abcminiuser/explorerbot/Thesis/Chapters/Chapter7.tex

\chapter{Project Discussion}
\label{chp:discussion}
\lhead{Chapter 7. \emph{Project Discussion}}

% TODO

\section{Issues Faced}

% TODO

\subsection{Motor Inrush Current}

% TODO

\subsection{PCA9306 Physical Package}

% TODO

\subsection{L298D Unavailabilty}

% TODO

\subsection{Incorrect Transistor Pinout}

% TODO

\subsection{Slow Drive Transistors}

% TODO

\subsection{Unreliable Packet Buffering}

% TODO

\subsection{PS3 Controller Compatibility}

% TODO

\subsection{Wii Controller Compatibility}

% TODO

\section{Project Significance}

% TODO
