abcminiuser/explorerbot/Thesis/Chapters/Chapter6.tex

\chapter{Project Results}
\label{chp:results}
\lhead{Chapter 6. \emph{Project Results}}

% TODO

\begin{figure}[tbph]
	\vspace{1em}
	\centering
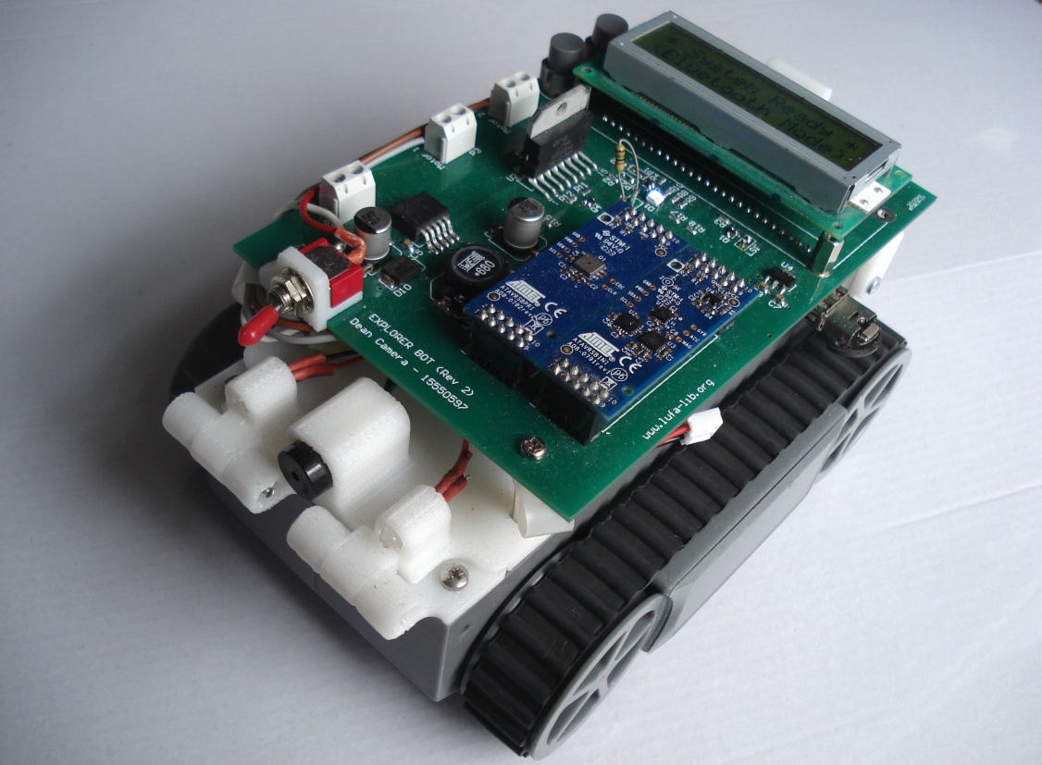
[picture p27: Thesis/Figures/CompletedRobot.jpg]
		
	\rule{35em}{0.5pt}
	\caption[Photo of Completed Robot]{Photo of the completed \textit{ExplorerBot} prototype robot}
	\label{fig:completedrobot}
\end{figure}

\begin{figure}[tbph]
	\vspace{1em}
	\centering
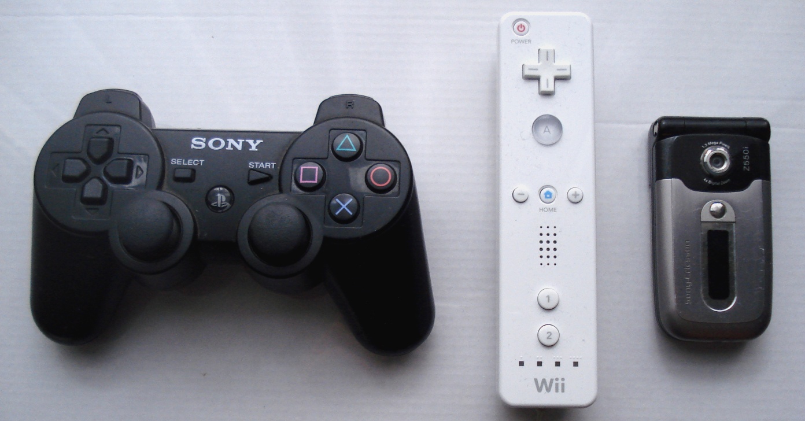
[picture p28: Thesis/Figures/BluetoothControllers.jpg]
		
	\rule{35em}{0.5pt}
	\caption[Tested Working Controllers]{Tested consumer grade Bluetooth enabled devices: \\ Playstation 3 controller \textit{(left)}, Nintendo Wii controller \textit{(middle)}, Sony-Ericcson z550i mobile phone \textit{(right)} }
	\label{fig:workingbtcontrollers}
\end{figure}

\begin{figure}[tbph]
	\vspace{1em}
	\centering
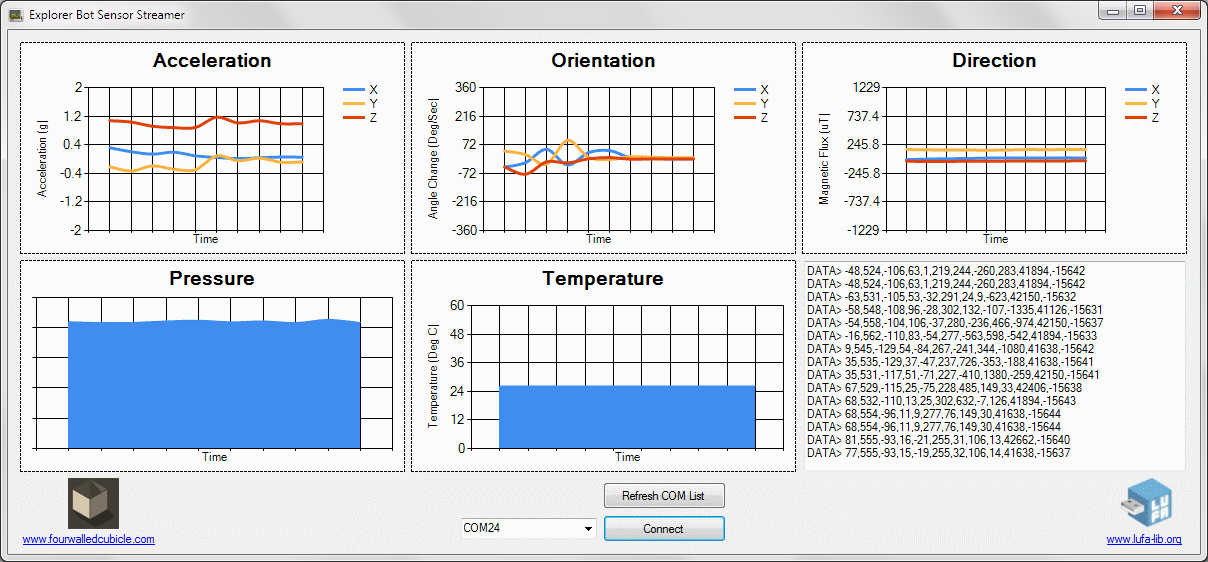
[picture p29: Thesis/Figures/SensorDataApp.png]
		
	\rule{35em}{0.5pt}
	\caption[Sensor Logging Host Application]{Sensor logging application, showing data streaming wirelessly from the connected robot via a Bluetooth virtual serial port. }
	\label{fig:sensorhostapp}
\end{figure}
