abcminiuser/explorerbot/End Year Presentation.pptx

Embedded Bluetooth Stack

Dean Camera
Supervisor: Prof. John Devlin
Co-Supervisor: Robert Ross

## Project Aims

Embedded Bluetooth Stack Page 2

- Develop a functional Bluetooth stack
  - Designed for embedded use
  - Focus on low resource usage
    - Memory Requirements
    - CPU Requirements
  - No RTOS requirements
- Design and build a functional hardware prototype to demonstrate the stack

## Bluetooth Stack

Embedded Bluetooth Stack Page 3

## Bluetooth Stack Layers

Embedded Bluetooth Stack Page 4

SDP

Other Services

High level abstracted services

Logical Link Control
and Adaption Protocol

Logical channel management within a device connection

Baseband management including physical connections between devices

Sends/Receives packets to and from the Bluetooth Controller
  - USB
  - Serial

Host Controller Interface

Physical Transport

## Completed Bluetooth Stack

Embedded Bluetooth Stack Page 5

- Supports multiple concurrent connections
- Multiple logical channels per connection
- L2CAP reliability through a dedicated internal queue
- API for integration into user applications

## Bluetooth Services

Embedded Bluetooth Stack Page 6

- RF Communication (RFCOMM)
  - Server role only
  - Provides wireless serial port functionality
- Human Interface Device (HID)
  - Very basic server implementation
  - Compatible with specific devices only

## Completed Services (Cont)

Embedded Bluetooth Stack Page 7

- Service Discovery Protocol (SDP)
  - Server implementation only
  - Allows for dynamic registration of other services

## Demonstration Hardware

Embedded Bluetooth Stack Page 8

## Hardware Overview

- Small battery operated “ExplorerBot” robot
- Allow for user control over Bluetooth connections
- Onboard sensors with wireless streaming

Embedded Bluetooth Stack Page 9

## Hardware Overview (Cont)

Embedded Bluetooth Stack Page 10

- Atmel Inertial One and Pressure One sensor boards
  - Accelerometer
  - Gyroscope
  - Magnetometer
  - Temperature Sensor
  - Pressure Sensor
- Level Converted I²C Bus

## Completed Prototype

Embedded Bluetooth Stack Page 11

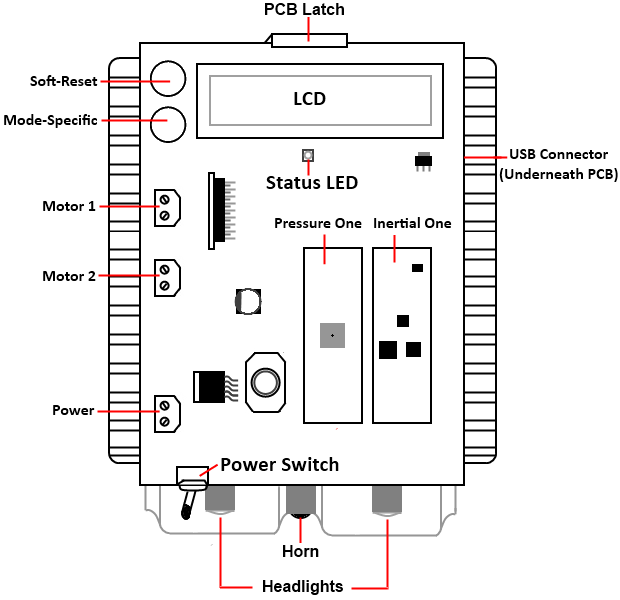
[picture p30: figure]
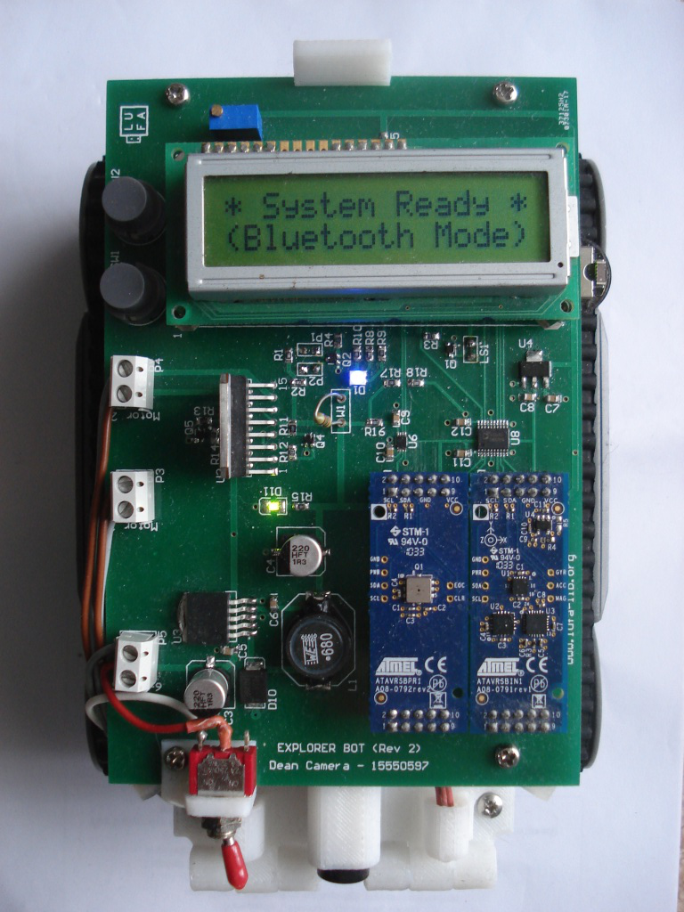
[picture p31: figure]

## Firmware Block Diagram

Embedded Bluetooth Stack Page 12

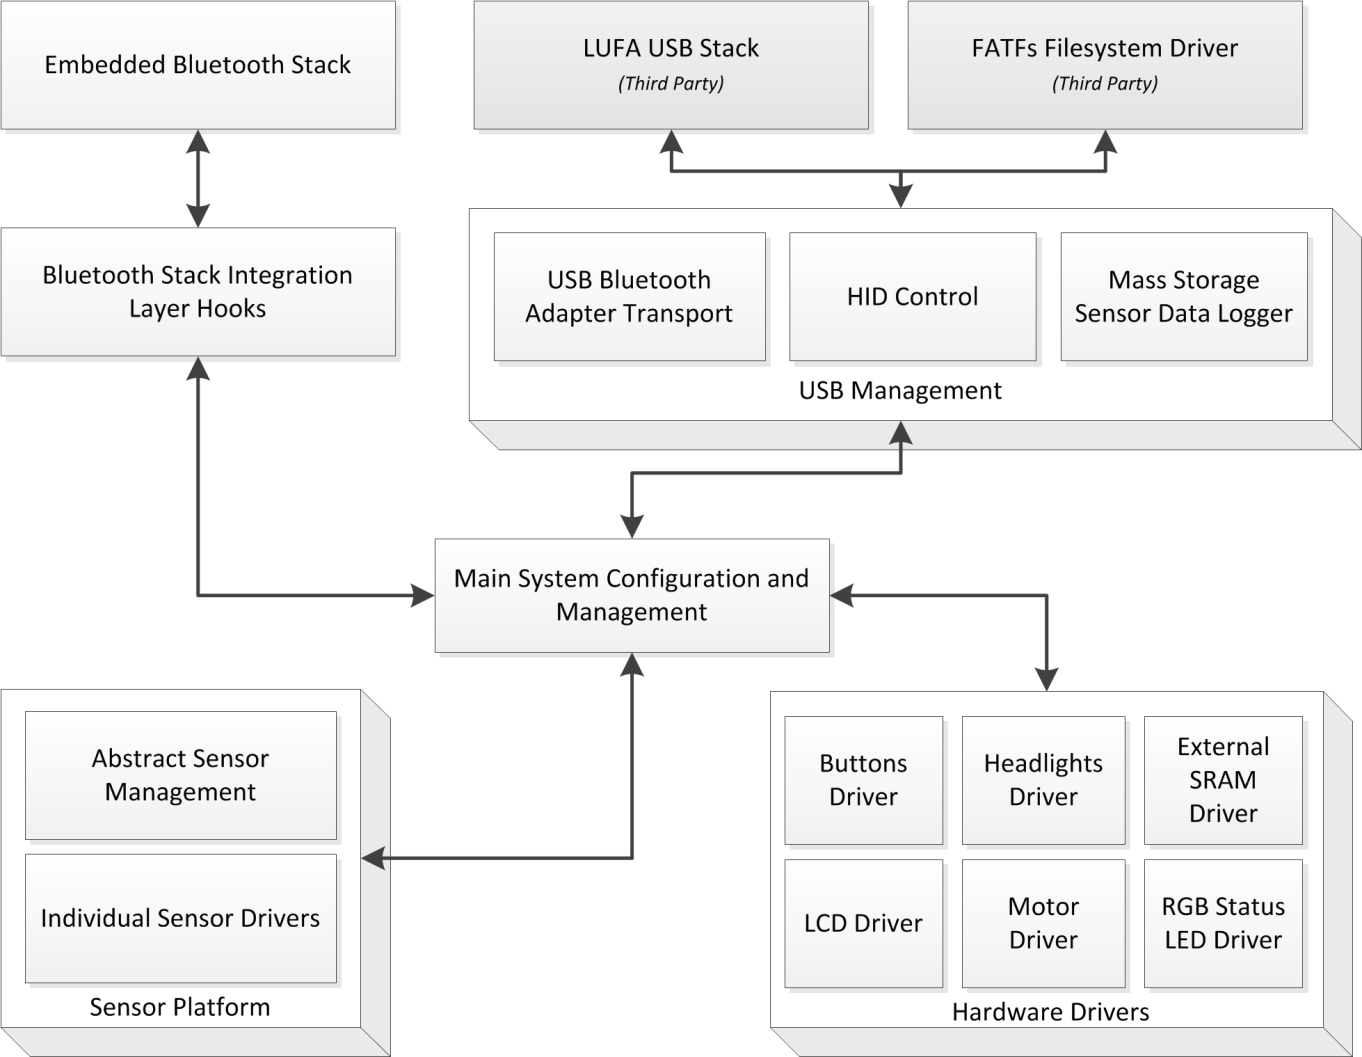
[picture p32: figure]

## Tested Bluetooth Devices

Embedded Bluetooth Stack Page 13

- Motors, horn and headlights controllable
  - Sony Ericson z550i Mobile Phone
  - Sony Playstation 3 Controller
  - Nintendo Wii Controller

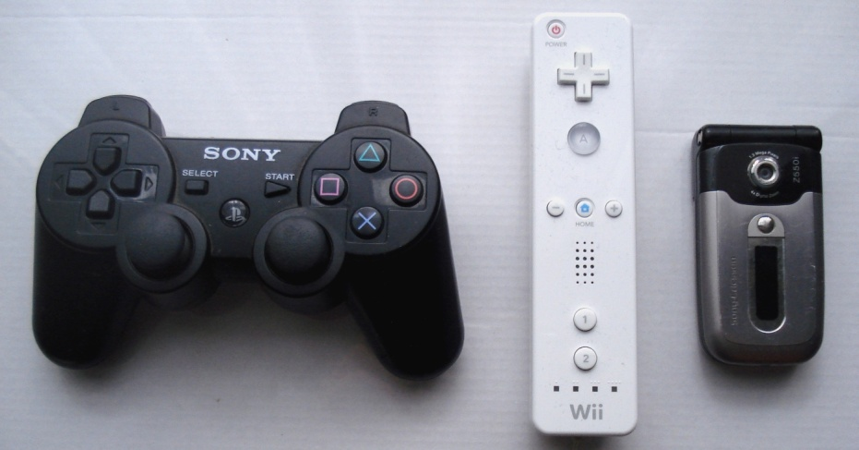
[picture p33: figure]

## Host Application

Embedded Bluetooth Stack Page 14

- Basic sensor streaming host application
  - Written in C#
  - Graphs sensor data from the robot in real time


## More Information

Embedded Bluetooth Stack Page 15

- All project materials (source code, thesis, presentations, photos) uploaded online
- Source code released under a MIT license
- Full SVN revision history available

www.fourwalledcubicle.com/ExplorerBot.php

## Slide 16

Example presentation title Page 16

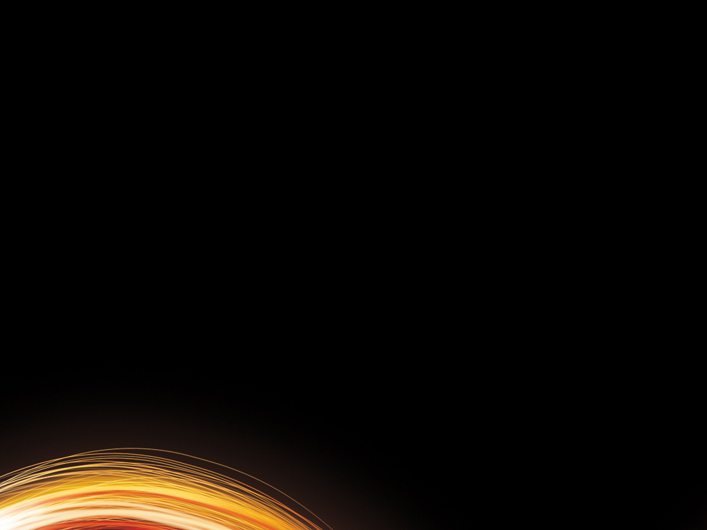
[picture p34: figure]
ltu_ppt_bg_red_corp3

Thank You

Notes: This is the “back slide” in your presentation to show that you have completed your presentation.
