abcminiuser/explorerbot/HostApplication/Resources/FourWalledCubicle.png

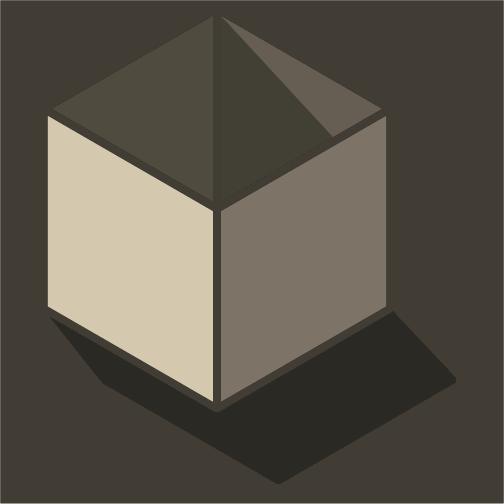
HostApplication/Resources/FourWalledCubicle.png
