abcminiuser/explorerbot/Photos/FinalYearRobot1.jpg

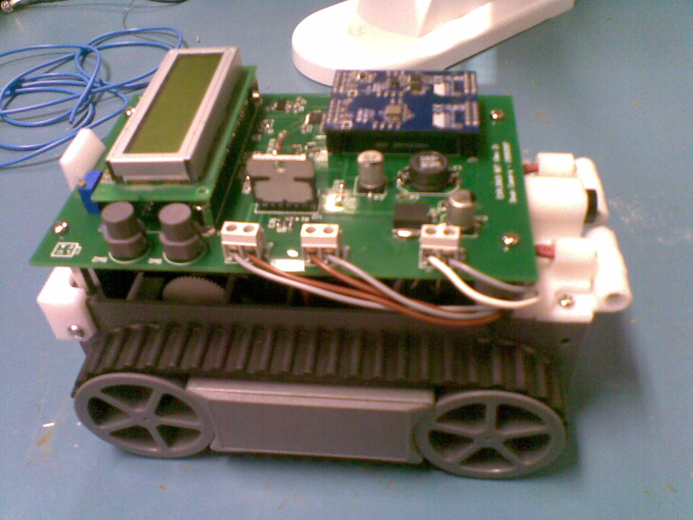
Photos/FinalYearRobot1.jpg
