abcminiuser/explorerbot/Photos/FinalYearRobot2.jpg

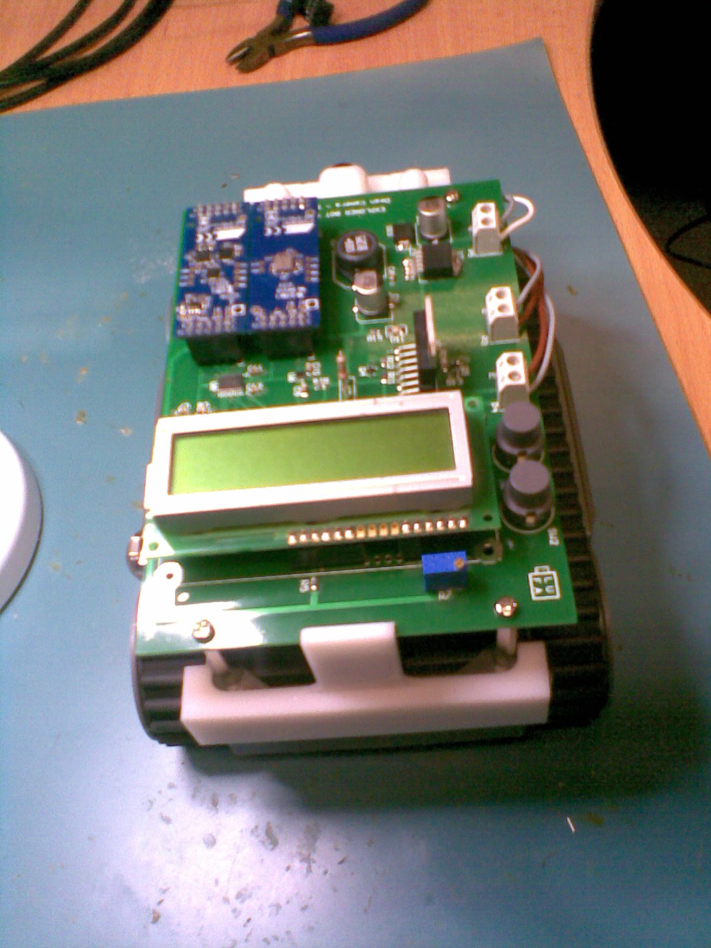
Photos/FinalYearRobot2.jpg
