abcminiuser/explorerbot/Photos/FinalYearRobot3.jpg

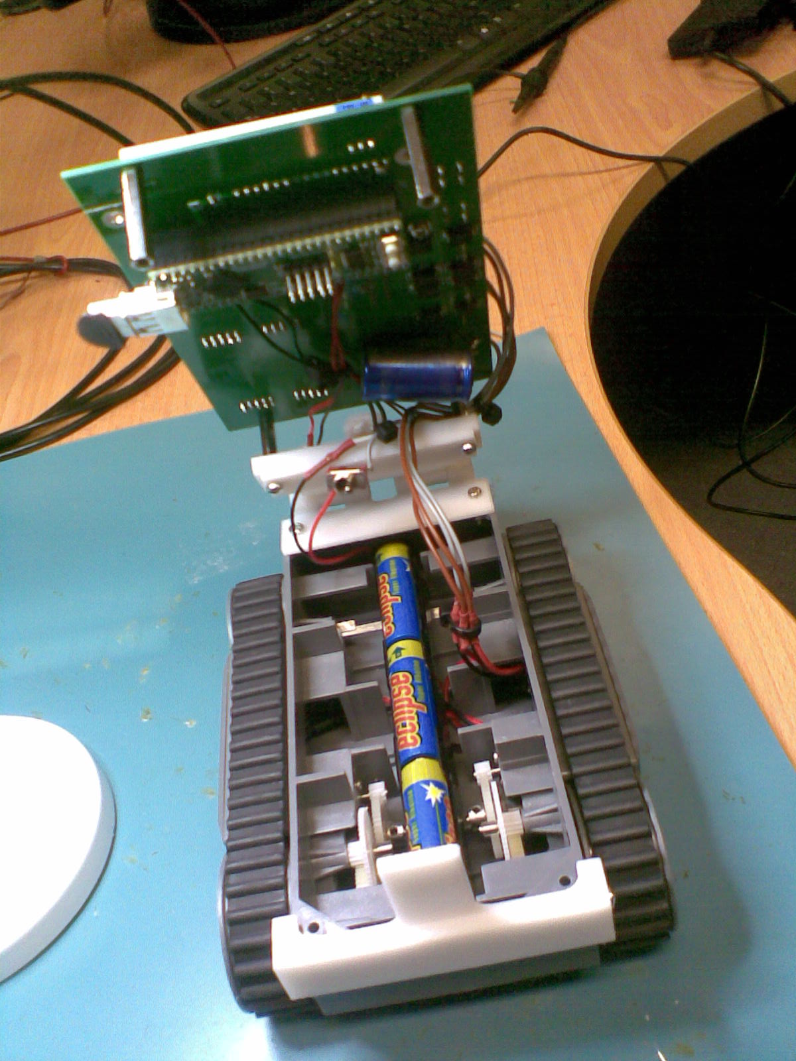
Photos/FinalYearRobot3.jpg
