abcminiuser/explorerbot/Photos/FinalYearRobot4.jpg

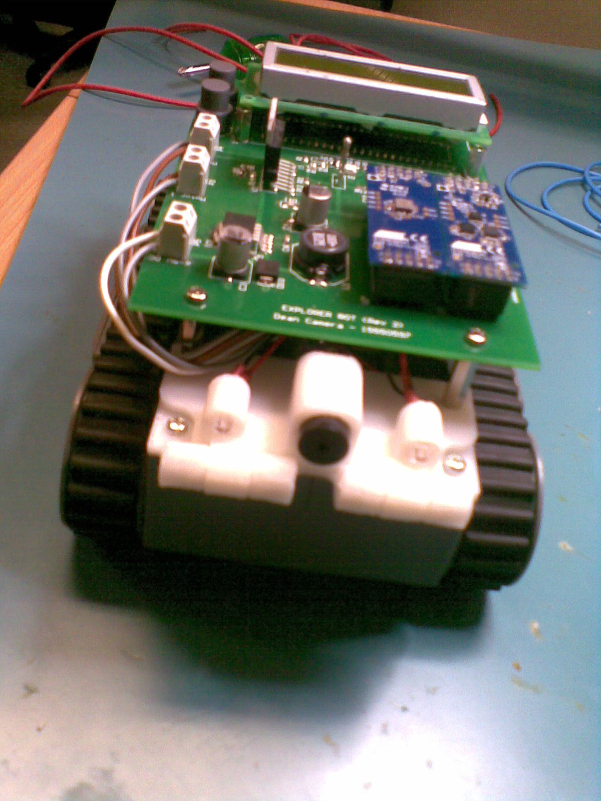
Photos/FinalYearRobot4.jpg
