abcminiuser/explorerbot/Photos/FinalYearRobot5.jpg

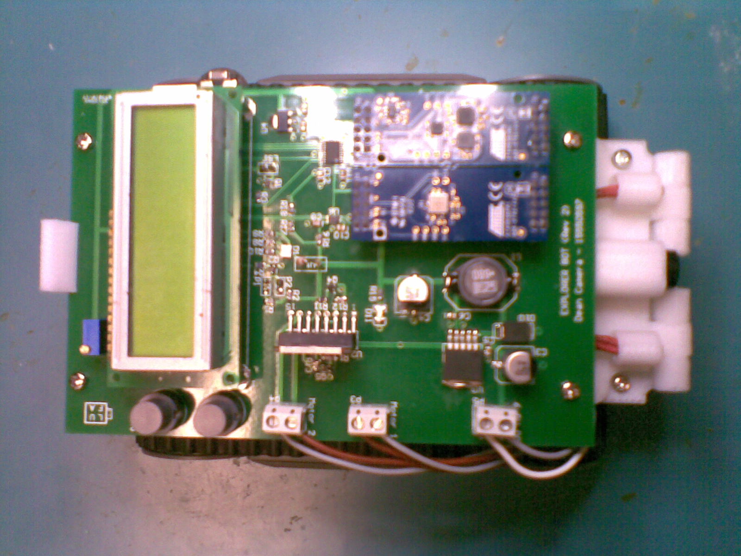
Photos/FinalYearRobot5.jpg
