abcminiuser/explorerbot/Photos/FinalYearRobot6.jpg

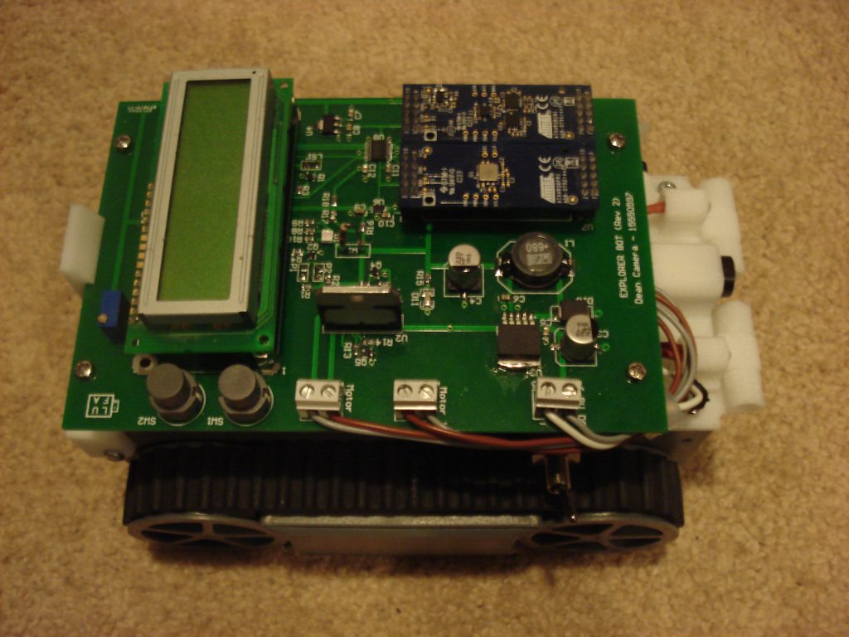
Photos/FinalYearRobot6.jpg
