abcminiuser/explorerbot/Photos/FinalYearRobot7.jpg

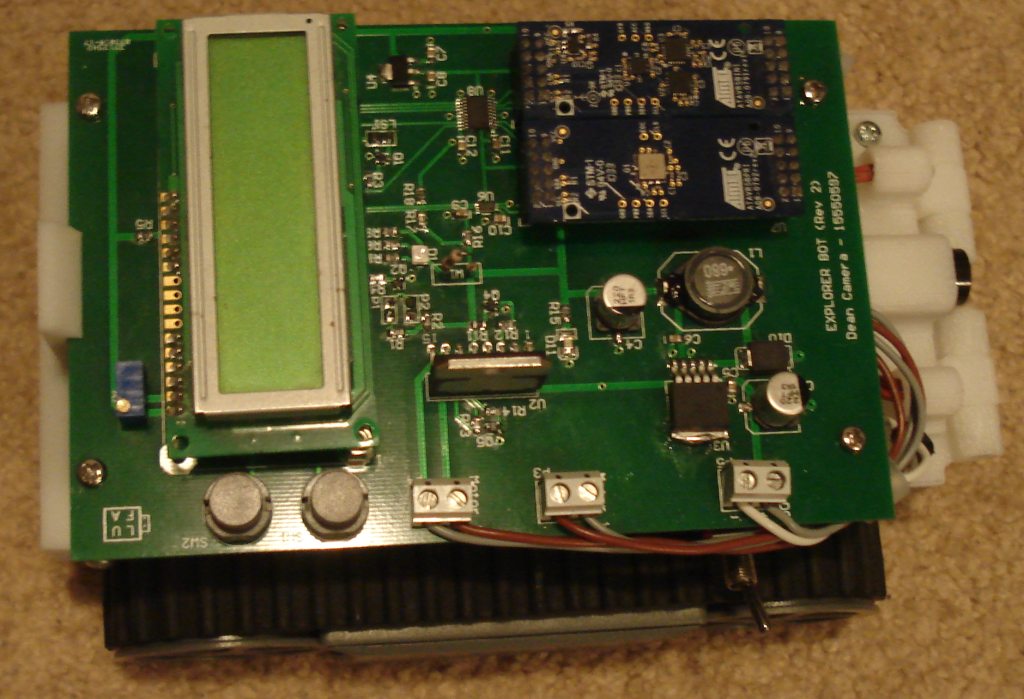
Photos/FinalYearRobot7.jpg
