abcminiuser/explorerbot/Photos/FinalYearRobot8.jpg

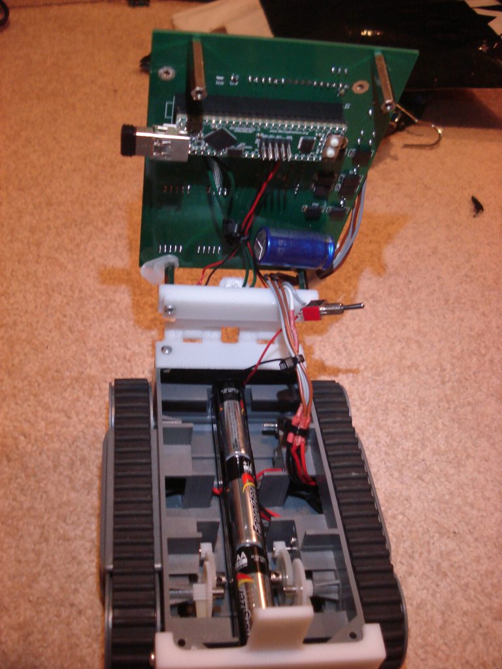
Photos/FinalYearRobot8.jpg
