abcminiuser/explorerbot/Photos/FinalYearRobot9.jpg

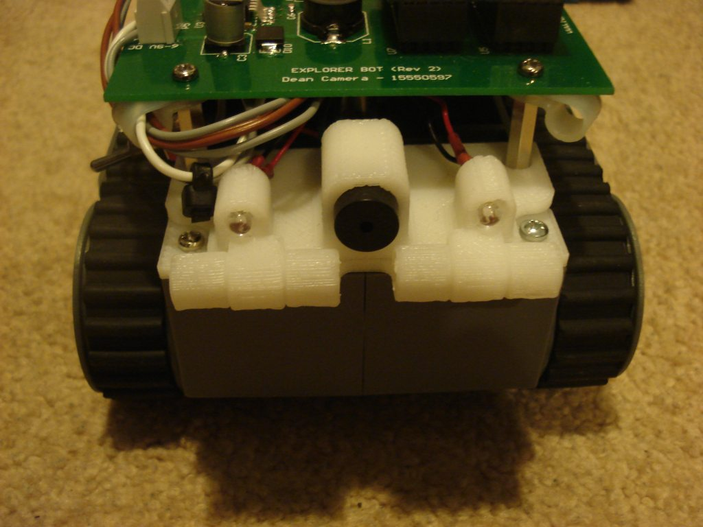
Photos/FinalYearRobot9.jpg
