abcminiuser/explorerbot/Photos/FinalYearRobot10.jpg

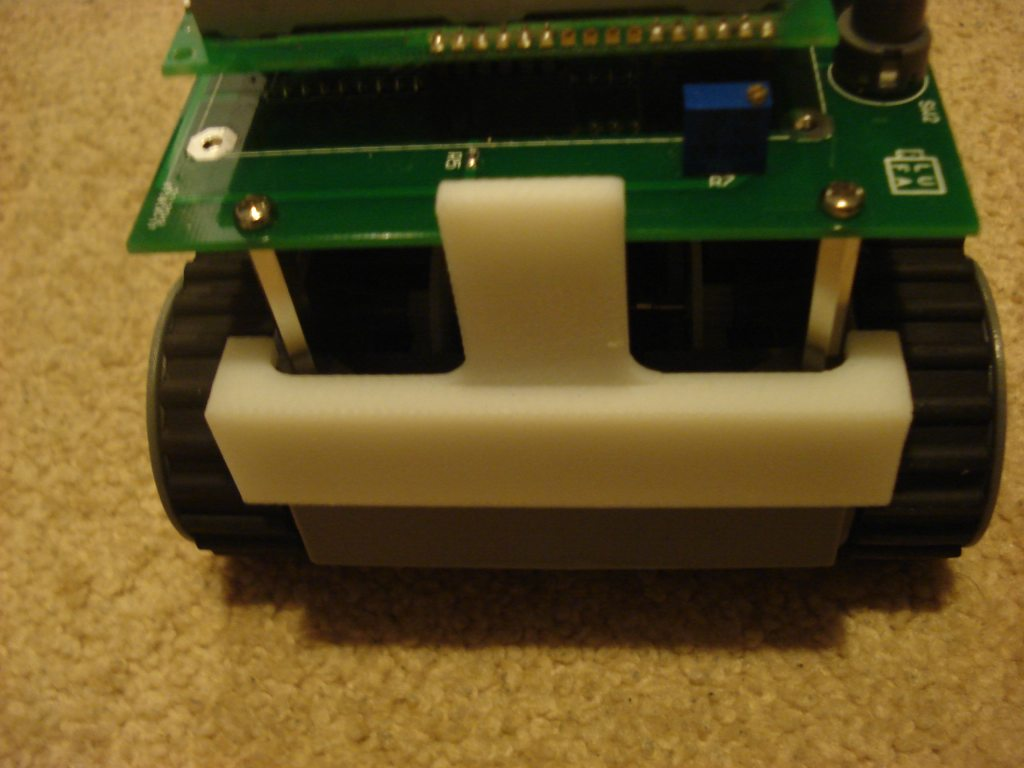
Photos/FinalYearRobot10.jpg
