abcminiuser/explorerbot/Photos/FinalYearRobot12.jpg

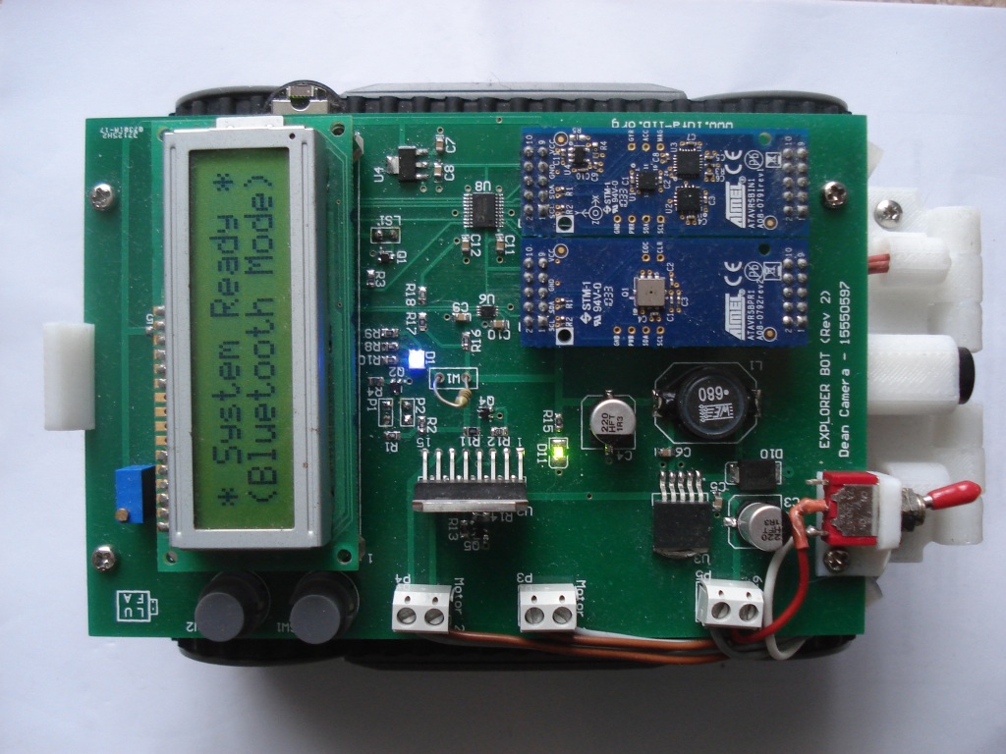
Photos/FinalYearRobot12.jpg
