abcminiuser/explorerbot/Thesis/Figures/RobotFront.png

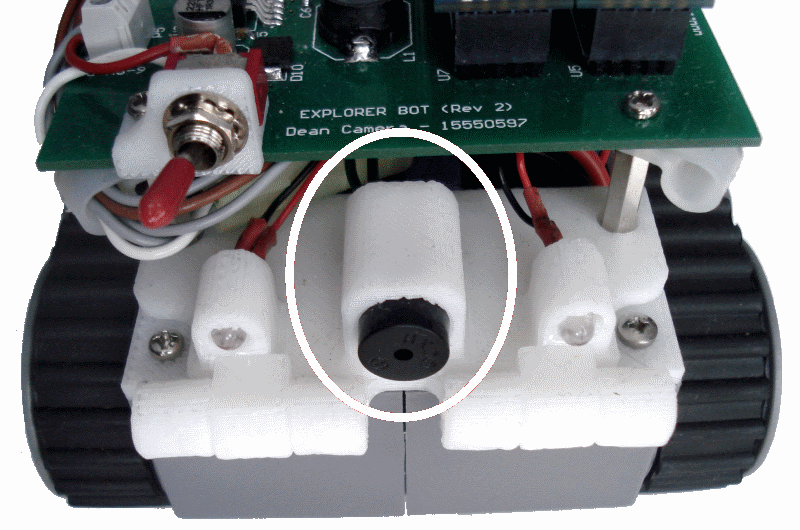
Thesis/Figures/RobotFront.png
