abcminiuser/explorerbot/Thesis/Figures/Source/LDO 3V.bmp

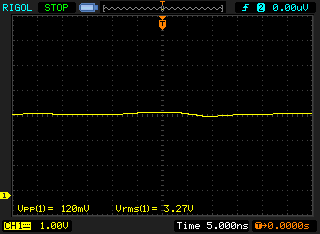
Thesis/Figures/Source/LDO 3V.bmp
