abcminiuser/explorerbot/Thesis/Figures/Source/Motor PWM.bmp

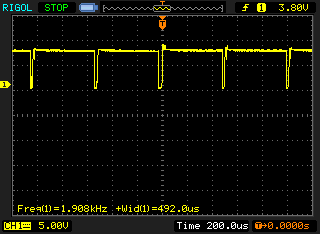
Thesis/Figures/Source/Motor PWM.bmp
