abcminiuser/explorerbot/Thesis/Figures/Source/Raw Battery Voltage.bmp

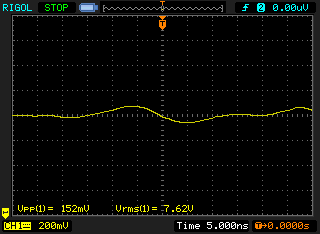
Thesis/Figures/Source/Raw Battery Voltage.bmp
