abcminiuser/explorerbot/Thesis/Figures/Source/Switchmode 5V.bmp

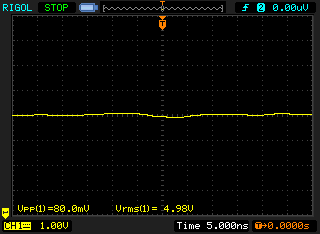
Thesis/Figures/Source/Switchmode 5V.bmp
