abcminiuser/explorerbot/Thesis/Appendices/Schematics.pdf

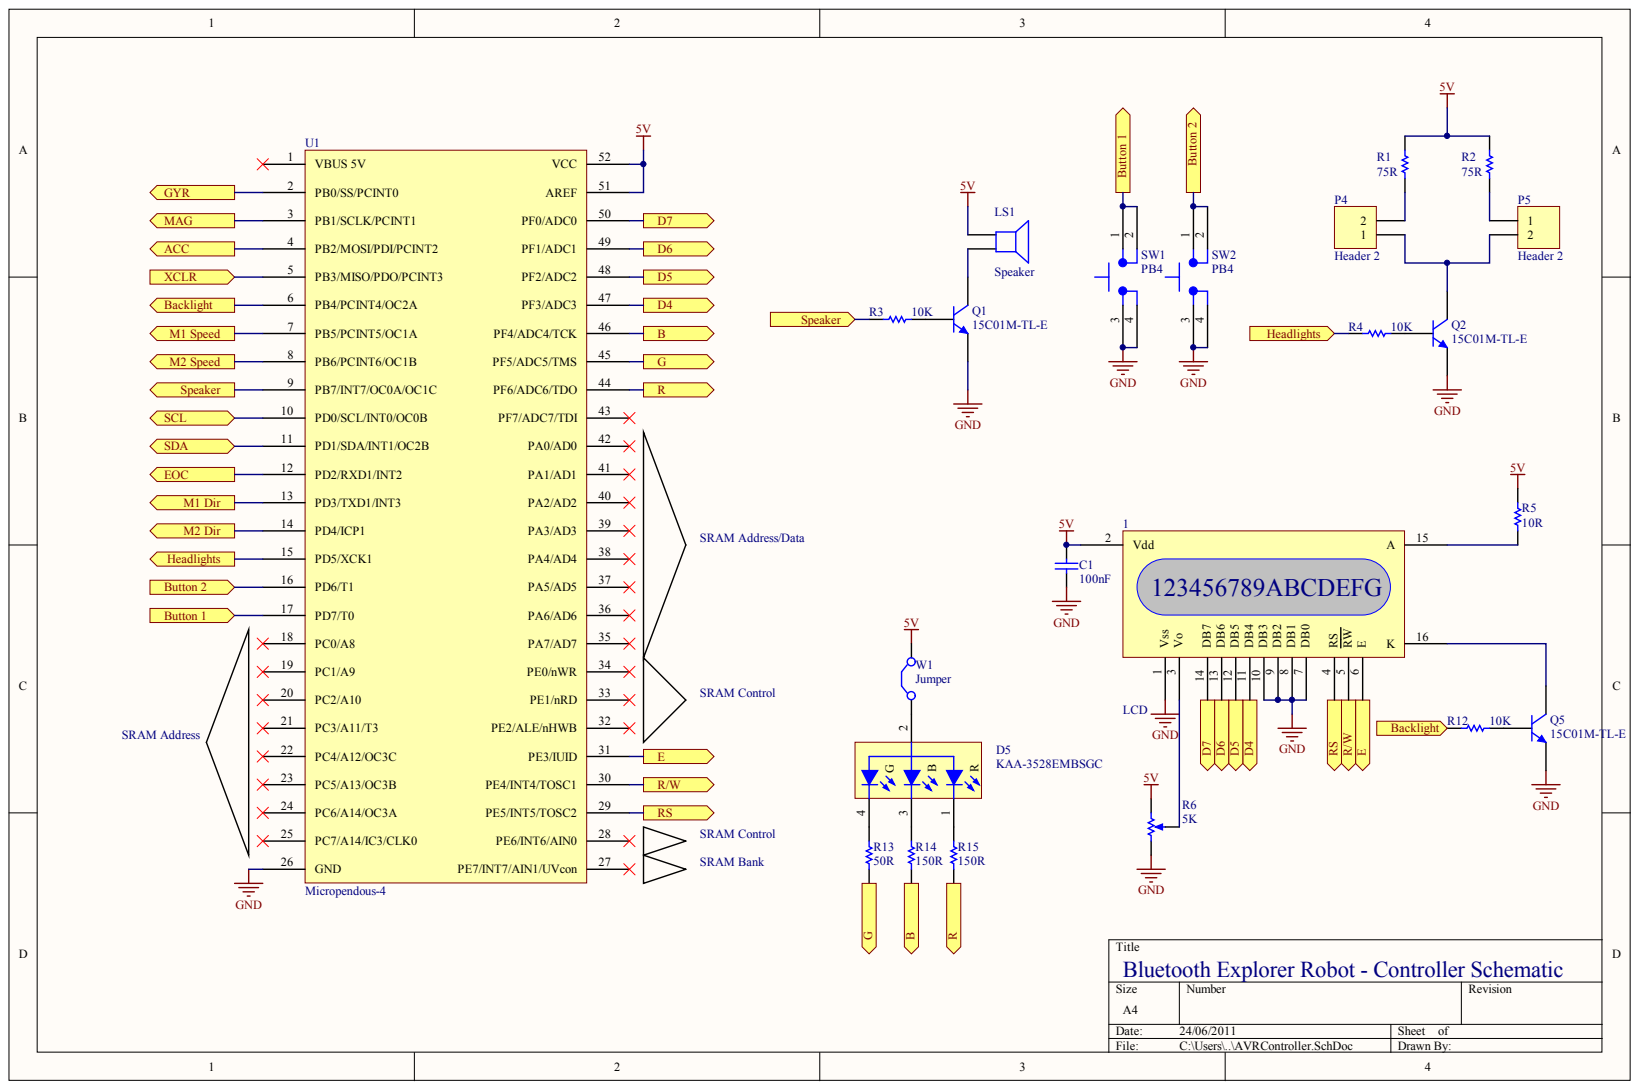
[picture p104: page 1]

Title Size
luetooth Explorer Robot - Control

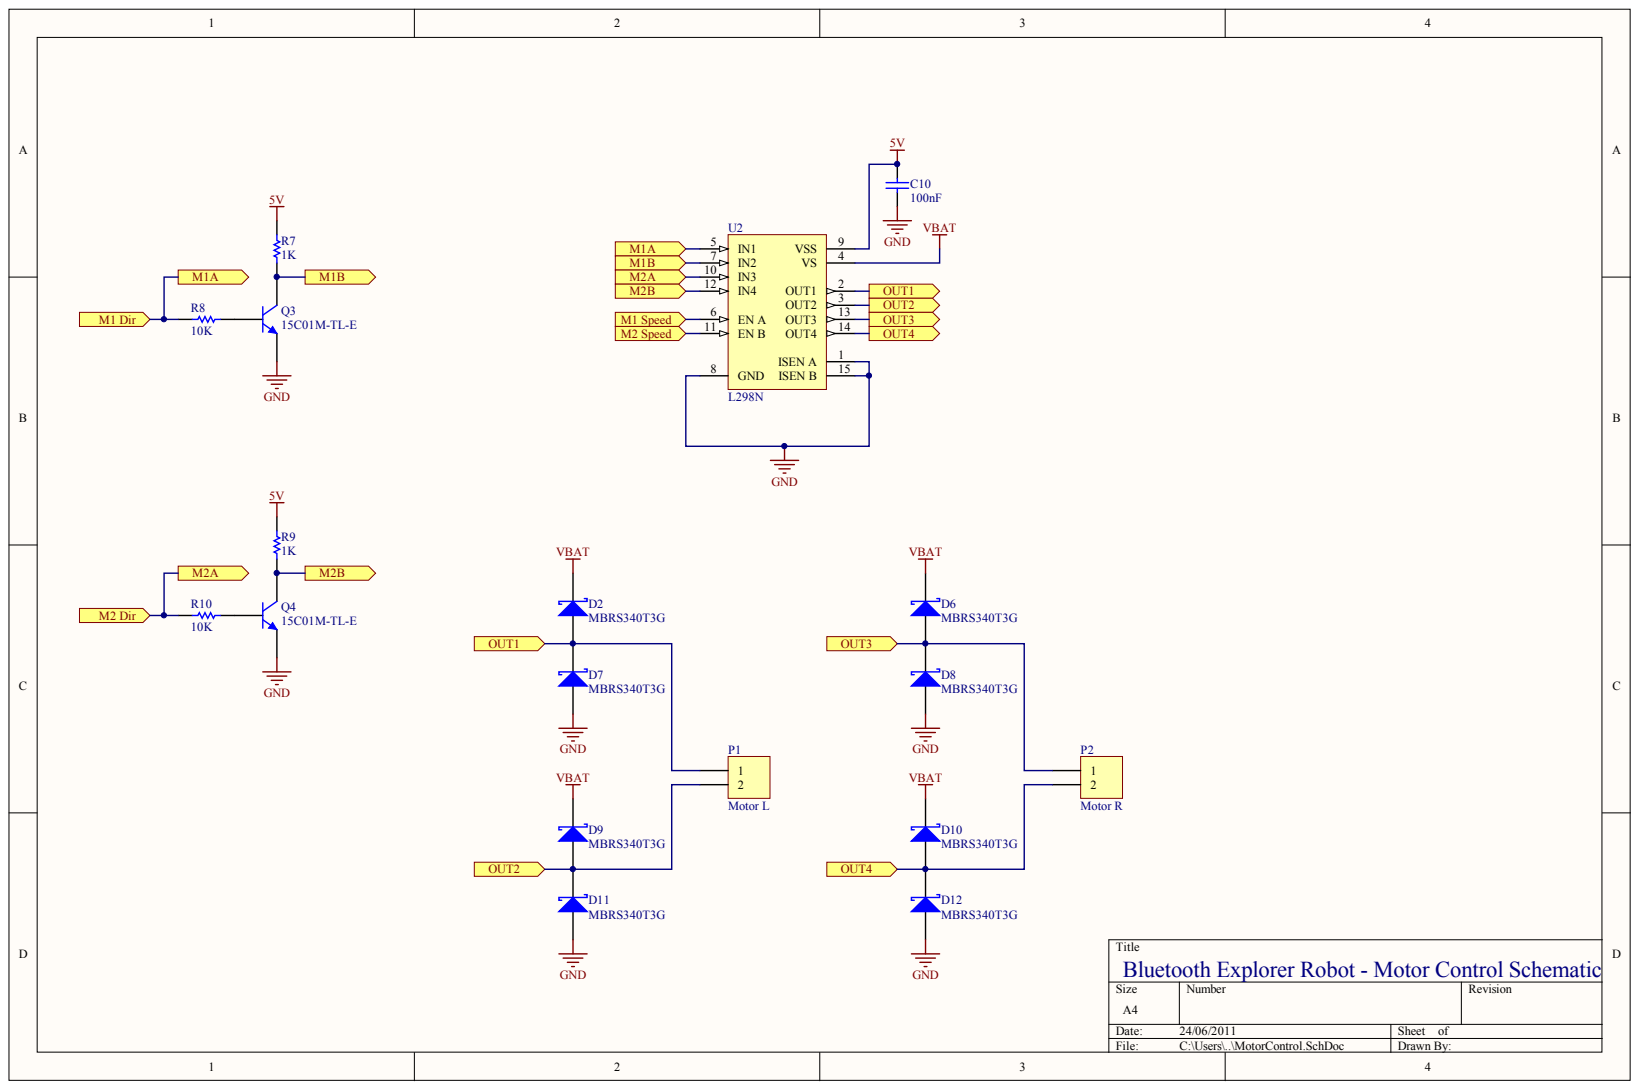
[picture p105: page 2]

Title
Bluetooth Explorer Robot - Motor Control Schematic

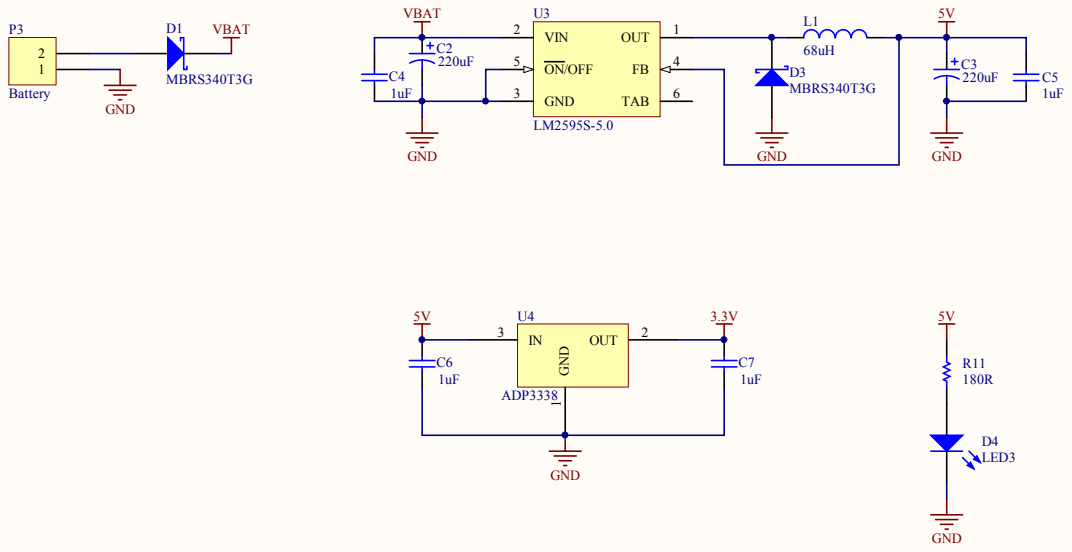
[picture p106: page 3]

Title Size
luetooth Explorer Robot - Power Suppl

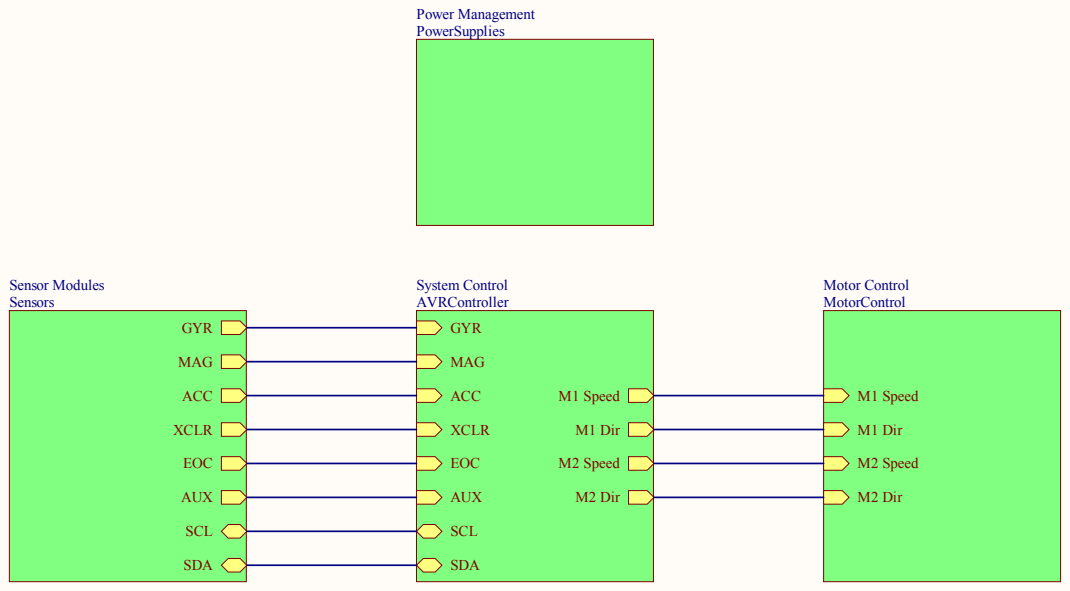
[picture p107: page 4]

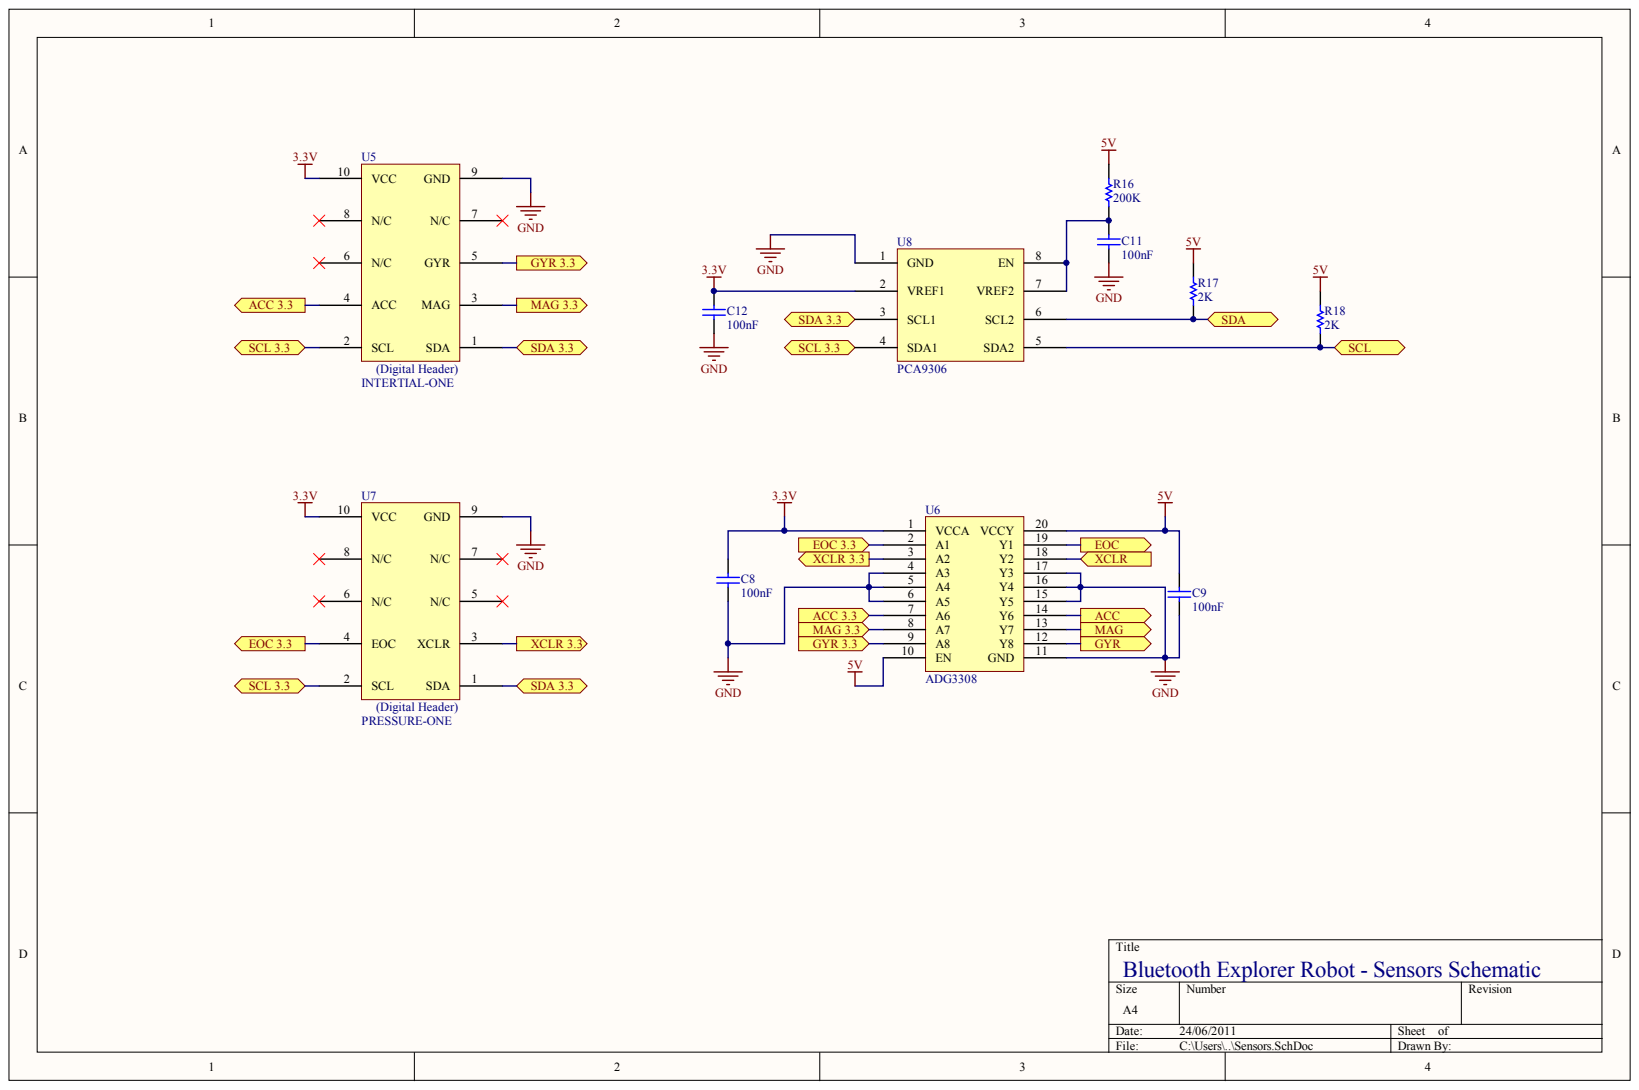
[picture p108: page 5]

A5 6 | | ACC

A7 8 | | MAG GYR

Title
Bluetooth Explorer Robot - Sensors Schematic

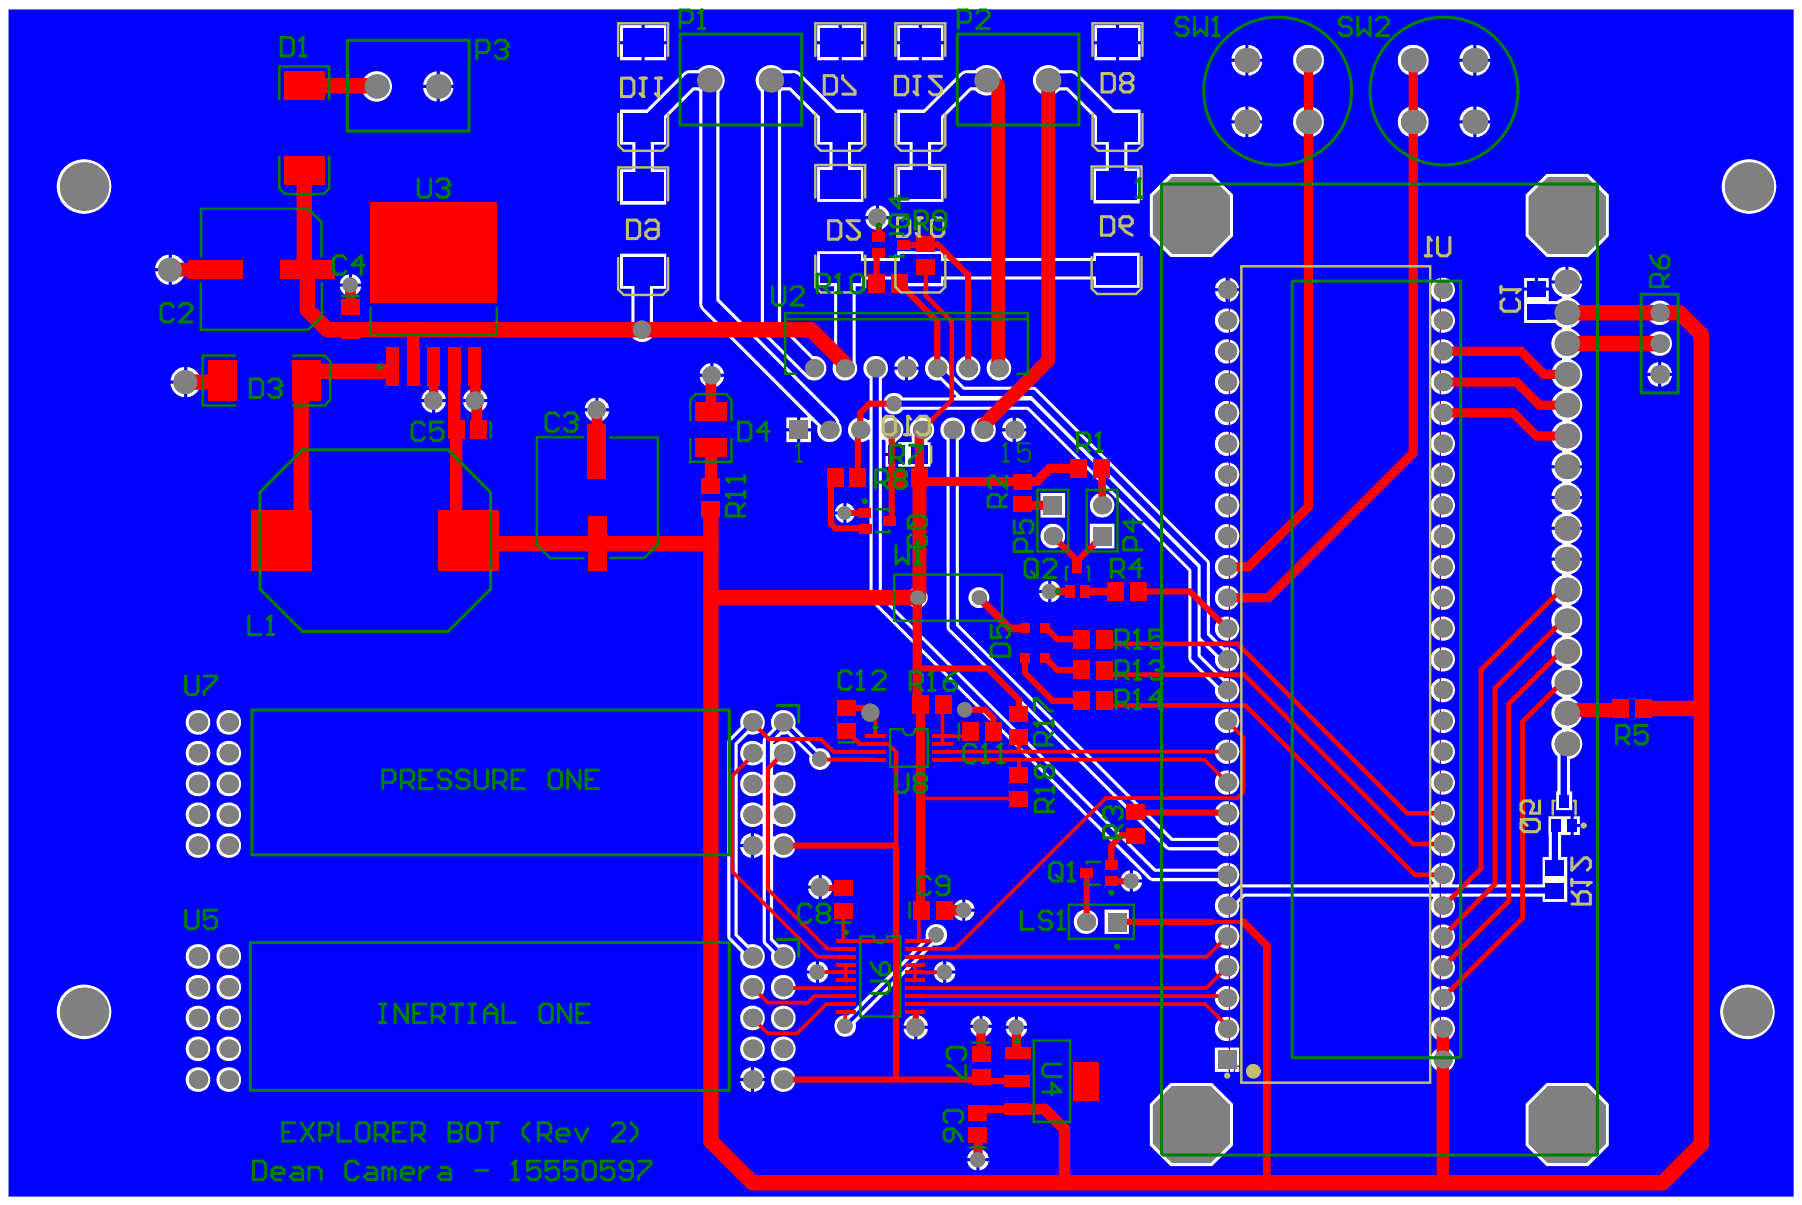
[picture p109: page 6]
