abcminiuser/explorerbot/Thesis/Figures/Source/PCB Artwork Black and White.pdf

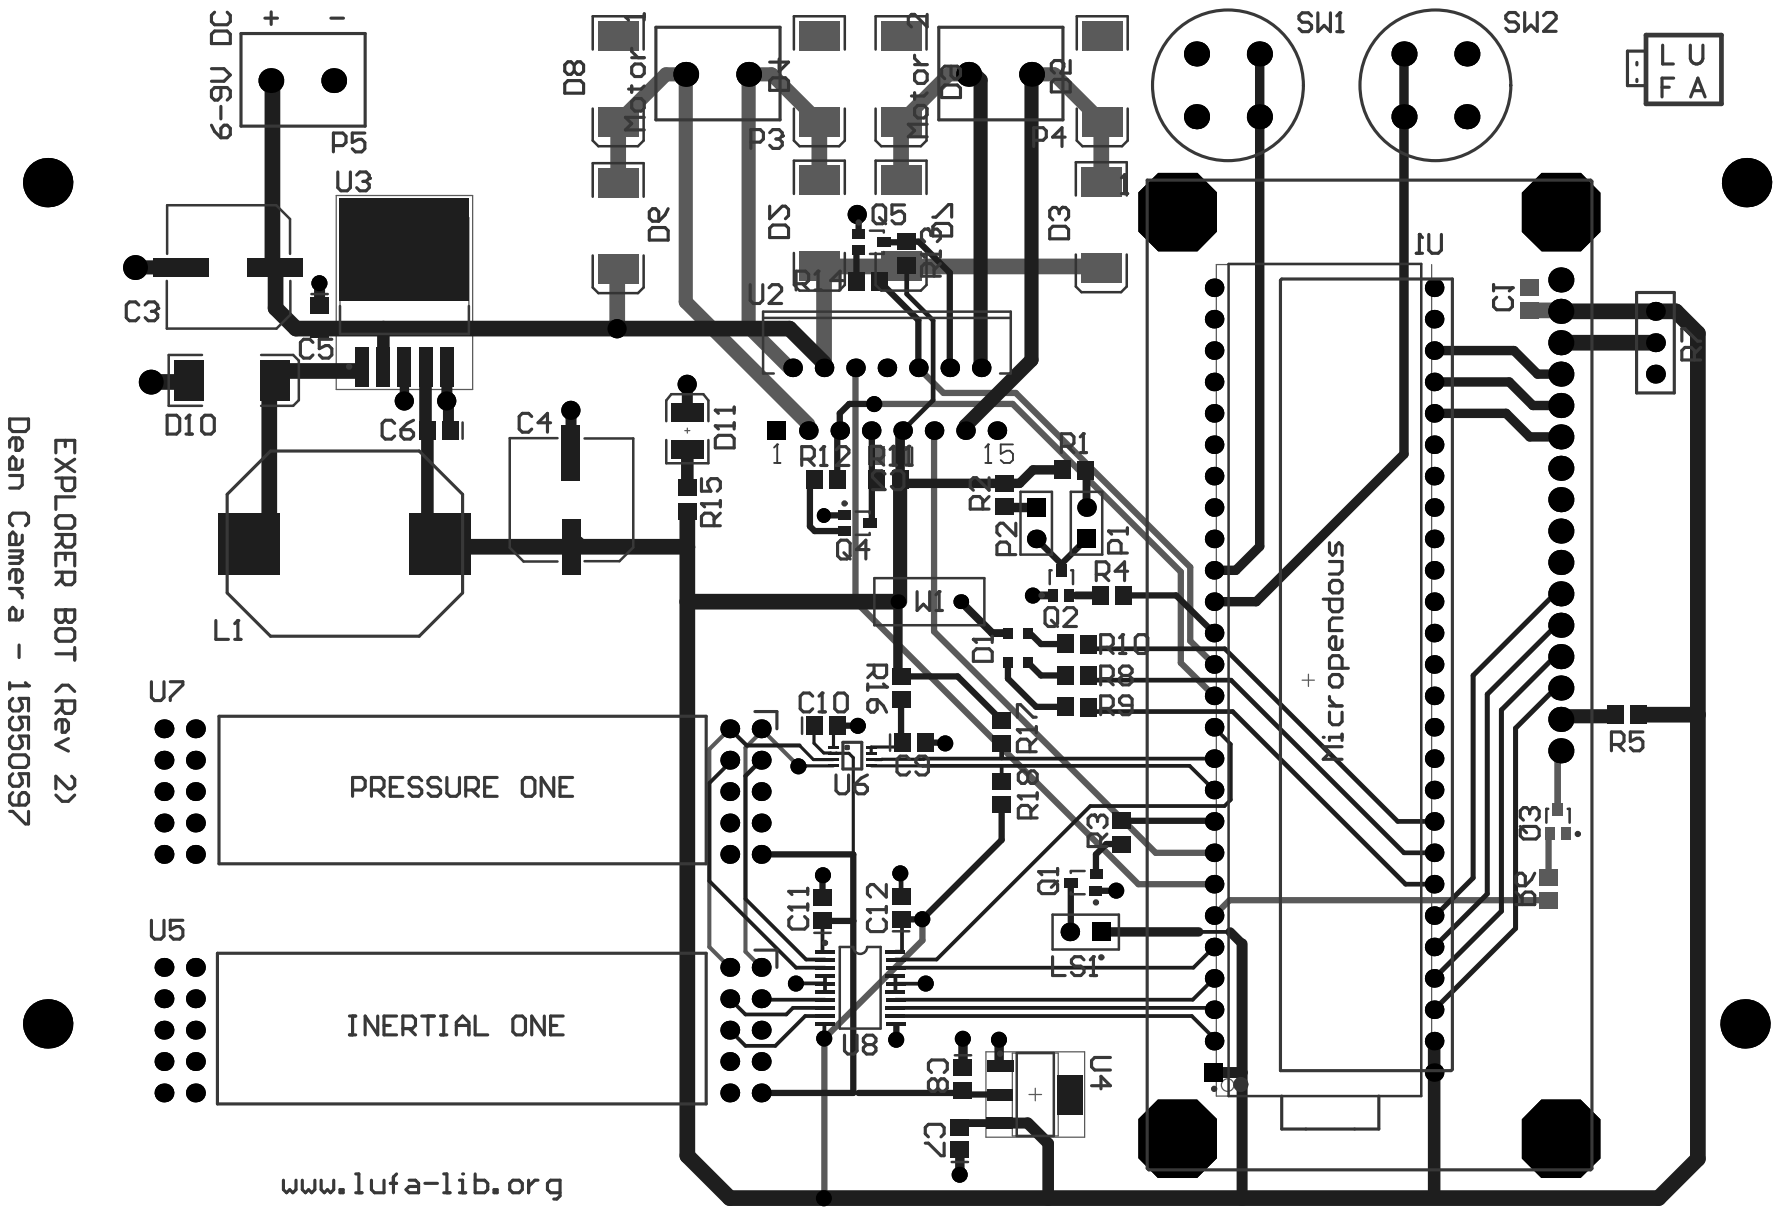
[picture p110: page 1]
