abcminiuser/explorerbot/(list of files, drawings)

Other design files:
Hardware/AtmelSensorBoards.PcbLib
Hardware/AtmelSensorBoards.SchLib
Hardware/AVRController.SchDoc
Hardware/Dual-In-Line Package.PcbLib
Hardware/IPC-SM-782 Section 8.1 Chip Resistor.PcbLib
Hardware/IPC-SM-782 Section 9.3 SOP.PcbLib
Hardware/Latrobe.PCBLIB
Hardware/Latrobe.SCHLIB
Hardware/Maxim Footprints.PcbLib
Hardware/Micropendous.SchLib
Hardware/MiscParts.PcbLib
Hardware/MiscParts.SchLib
Hardware/MotorControl.SchDoc
Hardware/Philips Footprints.PcbLib
Hardware/PowerSupplies.SchDoc
Hardware/Project.PcbDoc
Hardware/Project.PrjPCB
Hardware/Project.SchDoc
Hardware/Sensors.SchDoc
