abcminiuser/explorerbot/Code/BluetoothRobot.c

/*
             Bluetooth Robot
     Copyright (C) Dean Camera, 2011.

  dean [at] fourwalledcubicle [dot] com
        www.fourwalledcubicle.com
*/

/*
  Copyright 2011  Dean Camera (dean [at] fourwalledcubicle [dot] com)

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
  The author disclaim all warranties with regard to this
  software, including all implied warranties of merchantability
  and fitness.  In no event shall the author be liable for any
  special, indirect or consequential damages or any damages
  whatsoever resulting from loss of use, data or profits, whether
  in an action of contract, negligence or other tortious action,
  arising out of or in connection with the use or performance of
  this software.
*/

/** \file
 *
 *  Main module for the Bluetooth robot, configuring the system hardware and executing the sub-tasks that comprise
 *  the application.
 */

#include "BluetoothRobot.h"

/** Main program entry point. This routine configures the hardware required by the application, then
 *  enters a loop to run the application tasks in sequence.
 */
int main(void)
{
	SetupHardware();
	
	StartupSequence();
	CheckSensors();

	EVENT_USB_Host_DeviceUnattached();
	sei();
	
	for (;;)
	{
		uint8_t ButtonStatus = Buttons_GetStateMask();

		/* Mode action button */
		if (ButtonStatus & BUTTON1_MASK)
		{
			if (Disk_MS_Interface.State.IsActive)
			{
				MassStorage_SensorLoggingEnabled = true;
			
				LCD_WriteString_P(PSTR("\f  Disk Sensor\n"
				                         "Logging Enabled"));
			}
			else if (BluetoothAdapter_IsActive)
			{
				static BT_HCI_Connection_t* RemoteConnection = NULL;
				
				/* Only attempt a new connection if one does not already exist */
				if (!(RemoteConnection) || (RemoteConnection->State == HCI_CONSTATE_Closed))
				{
					/* Attempt a connection to the remote device whose BDADDR was retrieved from an attached flash drive previously */
					RemoteConnection = BluetoothAdapter_ConnectToRemoteDevice();
					
					/* Check if a new connection was created or not, display sucess/error */
					if (RemoteConnection)
					{
						LCD_WriteFormattedString_P(PSTR("\fHCI Connecting\n"
						                                  "%02X%02X:%02X%02X:%02X%02X"), RemoteConnection->RemoteBDADDR[5], RemoteConnection->RemoteBDADDR[4],
	                                                                                     RemoteConnection->RemoteBDADDR[3], RemoteConnection->RemoteBDADDR[2],
	                                                                                     RemoteConnection->RemoteBDADDR[1], RemoteConnection->RemoteBDADDR[0]);
						Speaker_PlaySequence(SPEAKER_SEQUENCE_Connecting);
					}
					else
					{
						LCD_WriteString_P(PSTR("\fHCI Conn Rej"));
						Speaker_PlaySequence(SPEAKER_SEQUENCE_ConnectFailed);
					}
				}
			}
		}
		  
		/* System reset button */
		if (ButtonStatus & BUTTON2_MASK)
		{
			Motors_SetChannelSpeed(0, 0);
			USB_Disable();
			
			wdt_enable(WDTO_15MS);
			for(;;);
		}

		/* Check if the system update interval has elapsed */
		if (TIFR3 & (1 << OCF3A))
		{
			/* Clear the timer compare flag */
			TIFR3 |= (1 << OCF3A);
		
			/* Update the currently playing tone through the speaker (if one is playing) */
			Speaker_TickElapsed();

			/* Update the LCD backlight counter to automatically dim the display */
			LCD_TickElapsed();
			
			/* If the bluetooth stack is active, manage timeouts within each layer */
			BluetoothAdapter_TickElapsed();

			static uint8_t SensorTicksElapsed = 0;
			
			/* Update sensors and log to disk/stream to remote device */
			if (SensorTicksElapsed++ == SENSOR_UPDATE_TICKS)
			{
				SensorTicksElapsed = 0;
								
				/* Update all connected sensors' values */
				Sensors_Update();

				/* Construct the next sensor CSV line from the current sensor data */
				char    LineBuffer[200];
				uint8_t LineLength = Sensors_WriteSensorDataCSV(LineBuffer);
				
				/* Write the sensor data to the attached Mass Storage disk (if available and logging enabled) */
				if (Disk_MS_Interface.State.IsActive && MassStorage_SensorLoggingEnabled)
				{
					uint16_t BytesWritten;
					f_write(&MassStorage_DiskLogFile, LineBuffer, LineLength, &BytesWritten);
					f_sync(&MassStorage_DiskLogFile);
				}

				/* Write the sensor data to the attached wireless serial port (if available) */
				if (RFCOMM_SensorStream && (RFCOMM_SensorStream->DataLink.RemoteSignals & RFCOMM_SIGNAL_RTR))
				  RFCOMM_SendData(RFCOMM_SensorStream, LineLength, LineBuffer);				
			}			
		}
		
		BluetoothAdapter_USBTask();
		Joystick_USBTask();
		MassStorage_USBTask();
		USB_USBTask();
	}
}

/** Configures the board hardware and chip peripherals for the demo's functionality. */
void SetupHardware(void)
{
	/* Disable watchdog if enabled by bootloader/fuses */
	MCUSR &= ~(1 << WDRF);
	wdt_disable();

	/* Disable clock division */
	clock_prescale_set(clock_div_1);

	/* Disable JTAG to allow RGB LEDs to work */
	JTAG_DISABLE();
	
	/* Disable unused peripheral modules */
	PRR0 = ((1 << PRADC) | (1 << PRSPI));
	PRR1 = (1 << PRUSART1);
	ACSR = (1 << ACD);
	
	/* Enable system update tick timer */
	TCCR3B = ((1 << WGM32) | (1 << CS31) | (1 << CS30));
	OCR3A  = ((F_CPU / 64) / (1000 / SYSTEM_TICK_MS));

	/* Hardware Initialization */
	ExternalSRAM_Init();
	Buttons_Init();
	Headlights_Init();
	LCD_Init(true);
	Motors_Init();
	RGB_Init();
	Sensors_Init();
	Speaker_Init();
	USB_Init();
}

/** System startup sequence, to test system hardware and display welcome/startup message to the user. */
void StartupSequence(void)
{
	const uint8_t ColourMap[] = {RGB_COLOUR_Green, RGB_COLOUR_Cyan,   RGB_COLOUR_Blue,  RGB_COLOUR_Magenta,
	                             RGB_COLOUR_Red,   RGB_COLOUR_Yellow, RGB_COLOUR_White, RGB_COLOUR_Off};

	LCD_WriteString_P(PSTR("\fBluetooth  Robot\n"
	                         " By Dean Camera "));

	/* Cycle through the RGB status LED colours */
	for (uint8_t i = 0; i < sizeof(ColourMap); i++)
	{
		RGB_SetColour(ColourMap[i]);
		Delay_MS(140);
	}
}

/** Check the board sensors to ensure that they are attached and operating correctly. */
void CheckSensors(void)
{
	static const uint8_t LCDIcon_Cross[] PROGMEM = {0x00, 0x1B, 0x0E, 0x04, 0x0E, 0x1B, 0x00, 0x00};
	static const uint8_t LCDIcon_Tick[]  PROGMEM = {0x00, 0x01, 0x03, 0x16, 0x1C, 0x08, 0x00, 0x00};
	
	LCD_SetCustomChar('\1', LCDIcon_Cross);
	LCD_SetCustomChar('\2', LCDIcon_Tick);
	
	LCD_Clear();
	LCD_WriteFormattedString_P(PSTR("\f CMP %c   ACC %c\n"
	                                  " GYR %c   PRS %c"), (Sensors.Direction.Connected    ? '\2' : '\1'),
	                                                       (Sensors.Acceleration.Connected ? '\2' : '\1'),
	                                                       (Sensors.Orientation.Connected  ? '\2' : '\1'),
	                                                       (Sensors.Pressure.Connected     ? '\2' : '\1'));

	Delay_MS(1500);
}

/** Updates the robot's hardware to match the control command given from the user.
 *
 *  \param[in]  MotorX            Motor X value coordinate in the direction map (3x3 matrix).
 *  \param[in]  MotorY            Motor Y value coordinate in the direction map (3x3 matrix).
 *  \param[in]  Horn              Turns on the robot's momentary horn.
 *  \param[in]  NoveltyHorn       Turns on the robot's novelty horn.
 *  \param[in]  Headlights        Turns on the robot's momentary headlights.
 *  \param[in]  HeadlightsToggle  Toggles the robot's headlights on/off.
 */
void ProcessUserControl(const int8_t MotorX,
                        const int8_t MotorY,
                        const bool Horn,
                        const bool NoveltyHorn,
                        const bool Headlights,
                        const bool HeadlightsToggle)
{
	static bool HeadlightsLatched = false;

	/* Table to map the controller direction coordinates to a pair of motor power coordinates (3x3 matrix), centered at coordinate (1, 1) */
	static const struct { int8_t Left; int8_t Right; } MotorPowerMap[3][3] =
		{
			{{  0,  1}, {  1,  1}, {  1,  0}},
			{{ -1,  1}, {  0,  0}, {  1, -1}},
			{{  0, -1}, { -1, -1}, { -1,  0}},
		};
		
	/* Change robot hardware states to match the values in the controller report */
	Motors_SetChannelSpeed((MotorPowerMap[MotorY][MotorX].Left  * (int16_t)MAX_MOTOR_POWER),
	                       (MotorPowerMap[MotorY][MotorX].Right * (int16_t)MAX_MOTOR_POWER));

	if (HeadlightsToggle)
	  HeadlightsLatched = !(HeadlightsLatched);
		
	if (NoveltyHorn)
	  Speaker_PlaySequence(SPEAKER_SEQUENCE_LaCucaracha);

	Headlights_SetState(HeadlightsLatched || Headlights);
	Speaker_Tone(Horn ? SPEAKER_HZ(HORN_FREQUENCY_HZ) : 0);	
}

/** Event handler for the USB_DeviceAttached event. This indicates that a device has been attached to the host, and
 *  starts the library USB task to begin the enumeration and USB management process.
 */
void EVENT_USB_Host_DeviceAttached(void)
{
	LCD_WriteString_P(PSTR("\f* Enumerating *"));
	RGB_SetColour(RGB_ALIAS_Enumerating);
}

/** Event handler for the USB_DeviceUnattached event. This indicates that a device has been removed from the host, and
 *  stops the library USB task management process.
 */
void EVENT_USB_Host_DeviceUnattached(void)
{
	Motors_SetChannelSpeed(0, 0);

	LCD_WriteString_P(PSTR("\f * Insert USB *"));
	RGB_SetColour(RGB_ALIAS_Disconnected);
}

/** Event handler for the USB_DeviceEnumerationComplete event. This indicates that a device has been successfully
 *  enumerated by the host and is now ready to be used by the application.
 */
void EVENT_USB_Host_DeviceEnumerationComplete(void)
{
	USB_Descriptor_Device_t DeviceDescriptor;
	uint16_t ConfigDescriptorSize;
	uint8_t  ConfigDescriptorData[512];

	LCD_WriteString_P(PSTR("\f* Configuring *"));

	if (USB_Host_GetDeviceDescriptor(&DeviceDescriptor) != HOST_SENDCONTROL_Successful)
	{
		LCD_WriteString_P(PSTR("\fERR: Dev Desc"));
		RGB_SetColour(RGB_ALIAS_Error);
		return;
	}

	if (USB_Host_GetDeviceConfigDescriptor(1, &ConfigDescriptorSize, ConfigDescriptorData,
	                                       sizeof(ConfigDescriptorData)) != HOST_GETCONFIG_Successful)
	{
		LCD_WriteString_P(PSTR("\fERR: Config Desc"));
		RGB_SetColour(RGB_ALIAS_Error);
		return;
	}

	Joystick_ConfigurePipes(&DeviceDescriptor, ConfigDescriptorSize, ConfigDescriptorData);
	BluetoothAdapter_ConfigurePipes(&DeviceDescriptor, ConfigDescriptorSize, ConfigDescriptorData);
	MassStorage_ConfigurePipes(&DeviceDescriptor, ConfigDescriptorSize, ConfigDescriptorData);
	
	if (!(Joystick_HID_Interface.State.IsActive) && !(Disk_MS_Interface.State.IsActive) && !(BluetoothAdapter_IsActive))
	{
		LCD_WriteString_P(PSTR("\fERR: Unknown USB"));
		RGB_SetColour(RGB_ALIAS_Error);
		return;
	}

	if (USB_Host_SetDeviceConfiguration(1) != HOST_SENDCONTROL_Successful)
	{
		LCD_WriteString_P(PSTR("\fERR: Set Config"));
		RGB_SetColour(RGB_ALIAS_Error);
		return;
	}
	
	if (!(Joystick_PostConfiguration()) || !(BluetoothAdapter_PostConfiguration()) || !(MassStorage_PostConfiguration()))
	{
		LCD_WriteString_P(PSTR("\fERR: Post Config"));
		RGB_SetColour(RGB_ALIAS_Error);
		return;
	}
	
	LCD_WriteString_P(PSTR("\f* System Ready *\n"));
	
	if (Joystick_HID_Interface.State.IsActive)
	  LCD_WriteString_P(PSTR("   (HID Mode)   "));
	else if (Disk_MS_Interface.State.IsActive)
	  LCD_WriteString_P(PSTR(" (MS Disk Mode) "));
	else if (BluetoothAdapter_IsActive)
	  LCD_WriteString_P(PSTR("(Bluetooth Mode)"));
	
	RGB_SetColour(RGB_ALIAS_Ready);
}

/** Event handler for the USB_HostError event. This indicates that a hardware error occurred while in host mode. */
void EVENT_USB_Host_HostError(const uint8_t ErrorCode)
{
	Motors_SetChannelSpeed(0, 0);
	USB_Disable();

	LCD_WriteString_P(PSTR("\fERR: VBUS Error"));
	RGB_SetColour(RGB_ALIAS_Error);
	for(;;);
}

/** Event handler for the USB_DeviceEnumerationFailed event. This indicates that a problem occurred while
 *  enumerating an attached USB device.
 */
void EVENT_USB_Host_DeviceEnumerationFailed(const uint8_t ErrorCode,
                                            const uint8_t SubErrorCode)
{
	LCD_WriteString_P(PSTR("\fERR: Device Enum"));
	RGB_SetColour(RGB_ALIAS_Error);
}
