abcminiuser/explorerbot/Code/Sensors/Sensors.c

/*
             Bluetooth Robot
     Copyright (C) Dean Camera, 2011.

  dean [at] fourwalledcubicle [dot] com
        www.fourwalledcubicle.com
*/

/*
  Copyright 2011  Dean Camera (dean [at] fourwalledcubicle [dot] com)

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
  The author disclaim all warranties with regard to this
  software, including all implied warranties of merchantability
  and fitness.  In no event shall the author be liable for any
  special, indirect or consequential damages or any damages
  whatsoever resulting from loss of use, data or profits, whether
  in an action of contract, negligence or other tortious action,
  arising out of or in connection with the use or performance of
  this software.
*/

/** \file
 *
 *  Sensor driver platform, to expose a common API for the control of the robot's various sensors.
 */

#include "Sensors.h"

/** Global sensor information structure, holding the last retrieved sensor values. */
Sensor_t Sensors;


/** Initializes the robot sensors mounted on the board, ready for use. This must be called before any other functions in the
 *  sensors hardware driver.
 */
void Sensors_Init(void)
{
	DDRB &= ~((1 << 0) | (1 << 1) | (1 << 2));
	DDRB |=  (1 << 3);
	DDRD &= ~(1 << 2);
	
	/* Set XCLR line high, to enable the pressure sensor */
	PORTB |= (1 << 3);
	
	/* Initialize the TWI bus at 200KHz for fastest possible read time */
	TWI_Init(TWI_BIT_PRESCALE_1, TWI_BITLENGTH_FROM_FREQ(1, 200000));
	
	/* Clear the sensor information table, reset all sensor data */
	memset(&Sensors, 0x00, sizeof(Sensors));
	
	/* Pre-sensor initialization delay */
	Delay_MS(100);
	
	/* Attempt to initialize all sensors */
	AK8975_Init(&Sensors.Direction);
	BMA150_Init(&Sensors.Acceleration);
	BMP085_Init(&Sensors.Pressure);
	ITG3200_Init(&Sensors.Orientation, &Sensors.Temperature);
}

/** Updates the current raw values for each connected sensor. */
void Sensors_Update(void)
{
	/* Update all sensor table items from the new sensor values */
	AK8975_Update(&Sensors.Direction);
	BMA150_Update(&Sensors.Acceleration);
	BMP085_Update(&Sensors.Pressure);
	ITG3200_Update(&Sensors.Orientation, &Sensors.Temperature);
}

/** Creates a header suitable for CSV format files, describing the device sensors which have been initialized previously.
 *
 *  \note The caller is responsible for providing a line buffer large enough to hold the created string.
 *
 *  \param[out] LineBuffer  Buffer where the created sensor CSV header text can be stored.
 *
 *  \return Length of the constructed CSV header line.
 */
uint8_t Sensors_WriteSensorCSVHeader(char* const LineBuffer)
{
	/* Terminate the string at the very start, so that future strcat() calls work correctly */
	LineBuffer[0] = '\0';

	/* Log file created, print out sensor names */
	
	for (uint8_t SensorIndex = 0; SensorIndex < (sizeof(Sensors) / sizeof(SensorData_t)); SensorIndex++)
	{
		/* Retrieve a pointer to the current sensor in the sensor table */
		SensorData_t* CurrSensor = &((SensorData_t*)&Sensors)[SensorIndex];

		if (SensorIndex)
		  strcat(LineBuffer, ",");

		strcat(LineBuffer, CurrSensor->Name);

		if (!(CurrSensor->SingleAxis))
		  strcat(LineBuffer, ",,");
	}

	/* Add newline terminator to the end of the line */
	strcat(LineBuffer, "\r\n");

	/* Print out sensor axis */
	for (uint8_t SensorIndex = 0; SensorIndex < (sizeof(Sensors) / sizeof(SensorData_t)); SensorIndex++)
	{
		/* Retrieve a pointer to the current sensor in the sensor table */
		SensorData_t* CurrSensor = &((SensorData_t*)&Sensors)[SensorIndex];

		if (SensorIndex)
		  strcat(LineBuffer, ",");

		if (!(CurrSensor->SingleAxis))
		  strcat(LineBuffer, "X,Y,Z");
	}

	/* Add newline terminator to the end of the line */
	strcat(LineBuffer, "\r\n");
	
	return strlen(LineBuffer);
}

/** Creates a CSV format line of text, describing the device sensor values which have been retrieved previously.
 *
 *  \note The caller is responsible for providing a line buffer large enough to hold the created string.
 *
 *  \param[out] LineBuffer  Buffer where the created sensor CSV data text can be stored.
 *
 *  \return Length of the constructed CSV header line.
 */
uint8_t Sensors_WriteSensorDataCSV(char* const LineBuffer)
{
	uint8_t OutputLen = 0;

	/* Terminate the string at the very start, so that future strcat() calls work correctly */
	LineBuffer[0] = '\0';

	for (uint8_t SensorIndex = 0; SensorIndex < (sizeof(Sensors) / sizeof(SensorData_t)); SensorIndex++)
	{
		/* Retrieve a pointer to the current sensor in the sensor table */
		SensorData_t* CurrSensor = &((SensorData_t*)&Sensors)[SensorIndex];

		if (SensorIndex)
		  LineBuffer[OutputLen++] = ',';
	
		/* Print the current sensor data into the temporary buffer */
		if (CurrSensor->SingleAxis)
		  OutputLen += sprintf(&LineBuffer[OutputLen], "%ld", CurrSensor->Data.Single);
		else
		  OutputLen += sprintf(&LineBuffer[OutputLen], "%d,%d,%d", CurrSensor->Data.Triplicate.X, CurrSensor->Data.Triplicate.Y, CurrSensor->Data.Triplicate.Z);
	}
	
	/* Add newline terminator to the end of the line */
	strcat(LineBuffer, "\r\n");
	
	return strlen(LineBuffer);
}
