abcminiuser/explorerbot/Code/Drivers/Motors.c

/*
             Bluetooth Robot
     Copyright (C) Dean Camera, 2011.

  dean [at] fourwalledcubicle [dot] com
        www.fourwalledcubicle.com
*/

/*
  Copyright 2011  Dean Camera (dean [at] fourwalledcubicle [dot] com)

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
  The author disclaim all warranties with regard to this
  software, including all implied warranties of merchantability
  and fitness.  In no event shall the author be liable for any
  special, indirect or consequential damages or any damages
  whatsoever resulting from loss of use, data or profits, whether
  in an action of contract, negligence or other tortious action,
  arising out of or in connection with the use or performance of
  this software.
*/

/** \file
 *
 *  Driver for the robot's PWM motor controller H-Bridge IC.
 */

#include "Motors.h"


/** Initializes the Motors hardware driver ready for use. This must be called before any other
 *  functions in the Motors hardware driver.
 */
void Motors_Init(void)
{
	DDRD  |= ((1 << 3) | (1 << 4));
	DDRB  |= ((1 << 5) | (1 << 6));

	TCCR1A = (1 << WGM11);
	TCCR1B = ((1 << WGM13) | (1 << CS10));
	
	ICR1 = 0x0FFF;
	
	Motors_SetChannelSpeed(0, 0);
}

/** Sets the current speed of the robot motors.
 *
 *  \param[in] LeftPower   Motor power to set the left channel to, a value between 0 (off) and +/- \ref MAX_MOTOR_POWER.
 *  \param[in] RightPower  Motor power to set the left channel to, a value between 0 (off) and +/- \ref MAX_MOTOR_POWER.
 */
void Motors_SetChannelSpeed(const int16_t LeftPower, const int16_t RightPower)
{
	bool LeftDirection  = (LeftPower  >= 0);
	bool RightDirection = (RightPower >= 0);
	bool LeftDirChange  = LeftDirection  ? !(PORTD & (1 << 4)) : (PORTD & (1 << 4));
	bool RightDirChange = RightDirection ? !(PORTD & (1 << 3)) : (PORTD & (1 << 3));

	/* If motor channel off or direction switching, disable the PWM output completely */
	if (LeftDirChange || !(LeftPower))
	{
		TCCR1A &= ~(1 << COM1B1);
		PORTB  &= ~(1 << 5);	
	}
	
	/* If motor channel off or direction switching, disable the PWM output completely */
	if (RightDirChange || !(RightPower))
	{
		TCCR1A &= ~(1 << COM1A1);
		PORTB  &= ~(1 << 6);	
	}
	
	/* Delay on direction change to wait until slow inverter transistors have finished switching to prevent voltage rail dips */
	if (LeftDirChange || RightDirChange)
	  Delay_MS(5);

	/* Set direction pin for left motor channel */
	if (LeftDirection)
	  PORTD |=  (1 << 4);
	else
	  PORTD &= ~(1 << 4);

	/* Set direction pin for right motor channel */
	if (RightDirection)
	  PORTD |=  (1 << 3);
	else
	  PORTD &= ~(1 << 3);

	/* Update motor PWM speed duty cycles, clamp to maximum allowable values */
	OCR1B = MIN(MAX_MOTOR_POWER, abs(LeftPower));
	OCR1A = MIN(MAX_MOTOR_POWER, abs(RightPower));

	/* If channel power non-zero, re-activate the PWM output */
	if (LeftPower)
	  TCCR1A |= (1 << COM1B1);

	/* If channel power non-zero, re-activate the PWM output */
	if (RightPower)
	  TCCR1A |= (1 << COM1A1);
}
