abcminiuser/explorerbot/Code/Bluetooth/Services/RFCOMM/RFCOMM.h

/*
             Bluetooth Robot
     Copyright (C) Dean Camera, 2011.

  dean [at] fourwalledcubicle [dot] com
        www.fourwalledcubicle.com
*/

/*
  Copyright 2011  Dean Camera (dean [at] fourwalledcubicle [dot] com)

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
  The author disclaim all warranties with regard to this
  software, including all implied warranties of merchantability
  and fitness.  In no event shall the author be liable for any
  special, indirect or consequential damages or any damages
  whatsoever resulting from loss of use, data or profits, whether
  in an action of contract, negligence or other tortious action,
  arising out of or in connection with the use or performance of
  this software.
*/

/** \file
 *
 *  Header file for RFCOMM.h.
 */

#ifndef _RFCOMM_SERVICE_H_
#define _RFCOMM_SERVICE_H_

	/* Includes: */
		#include <stdbool.h>
		#include <stdint.h>

		#include "../../Bluetooth.h"
		#include "../SDP/SDP.h"
		#include "RFCOMMServiceTable.h"

	/* Macros: */
		#define FRAME_POLL_FINAL                 (1 << 4)

		#define RFCOMM_CONTROL_DLCI              0
		#define RFCOMM_MAX_OPEN_CHANNELS         5

		#define RFCOMM_CONFIG_REMOTESIGNALS      (1 << 0)
		#define RFCOMM_CONFIG_LOCALSIGNALS       (1 << 1)
		#define RFCOMM_CONFIG_LOCALSIGNALSSENT   (1 << 2)
		#define RFCOMM_CONFIG_ABMMODESET         (1 << 3)

		#define RFCOMM_SIGNAL_FC                 (1 << 1)
		#define RFCOMM_SIGNAL_RTC                (1 << 2)
		#define RFCOMM_SIGNAL_RTR                (1 << 3)
		#define RFCOMM_SIGNAL_IC                 (1 << 6)
		#define RFCOMM_SIGNAL_DV                 (1 << 7)

		#define RFCOMM_RPN_PMASK_BITRATE         (1 << 0)
		#define RFCOMM_RPN_PMASK_DATABITS        (1 << 1)
		#define RFCOMM_RPN_PMASK_STOPBITS        (1 << 2)
		#define RFCOMM_RPN_PMASK_PARITY          (1 << 3)
		#define RFCOMM_RPN_PMASK_PARITYTYPE      (1 << 4)
		#define RFCOMM_RPN_PMASK_XON             (1 << 5)
		#define RFCOMM_RPN_PMASK_PXOFF           (1 << 6)

	/* Enums: */
		/** Enum for the types of RFCOMM frames which can be exchanged on a Bluetooth channel. */
		enum RFCOMM_Frame_Types_t
		{
			RFCOMM_Frame_DM                      = 0x0F, /**< Disconnected Mode Field */
			RFCOMM_Frame_DISC                    = 0x43, /**< Disconnect Field */
			RFCOMM_Frame_SABM                    = 0x2F, /**< Set Asynchronous Balance Mode Field */
			RFCOMM_Frame_UA                      = 0x63, /**< Unnumbered Acknowledgement Field */
			RFCOMM_Frame_UIH                     = 0xEF, /**< Unnumbered Information with Header check Field */
		};

		enum RFCOMM_Control_Commands_t
		{
			RFCOMM_Control_Test                  = (0x20 >> 2),
			RFCOMM_Control_FlowControlEnable     = (0xA0 >> 2),
			RFCOMM_Control_FlowControlDisable    = (0x60 >> 2),
			RFCOMM_Control_ModemStatus           = (0xE0 >> 2),
			RFCOMM_Control_RemotePortNegotiation = (0x90 >> 2),
			RFCOMM_Control_RemoteLineStatus      = (0x50 >> 2),
			RFCOMM_Control_ParameterNegotiation  = (0x80 >> 2),
			RFCOMM_Control_NonSupportedCommand   = (0x10 >> 2),
		};

		enum RFCOMM_Channel_States_t
		{
			RFCOMM_Channel_Closed                = 0,
			RFCOMM_Channel_Configure             = 1,
			RFCOMM_Channel_Open                  = 2,
		};

		enum RFCOMM_PortConfig_BaudRate_t
		{
			RFCOMM_BaudRate_2400                 = 0,
			RFCOMM_BaudRate_4800                 = 1,
			RFCOMM_BaudRate_7200                 = 2,
			RFCOMM_BaudRate_9600                 = 3,
			RFCOMM_BaudRate_19200                = 4,
			RFCOMM_BaudRate_38400                = 5,
			RFCOMM_BaudRate_57600                = 6,
			RFCOMM_BaudRate_115200               = 7,
			RFCOMM_BaudRate_230400               = 8,
		};

		enum RFCOMM_PortConfig_DataBits_t
		{
			RFCOMM_DataBits_5                    = 0,
			RFCOMM_DataBits_6                    = 1,
			RFCOMM_DataBits_7                    = 2,
			RFCOMM_DataBits_8                    = 3,
		};

		enum RFCOMM_PortConfig_StopBits_t
		{
			RFCOMM_StopBits_1                    = 0,
			RFCOMM_StopBits_1p5                  = 1,
		};

		enum RFCOMM_PortConfig_Parity_t
		{
			RFCOMM_Parity_Odd                    = 0,
			RFCOMM_Parity_Even                   = 1,
			RFCOMM_Parity_Mark                   = 2,
			RFCOMM_Parity_Space                  = 3,
		};

	/* Type Defines: */
		typedef struct
		{
			uint8_t  BaudRate;
			unsigned DataBits    : 2;
			unsigned StopBits    : 1;
			unsigned Parity      : 1;
			unsigned ParityType  : 2;
			unsigned Reserved    : 2;
			unsigned FlowControl : 6;
			uint8_t  XON;
			uint8_t  XOFF;
			uint16_t ParameterMask;
		} ATTR_PACKED RFCOMM_PortConfig_t;

		typedef struct
		{
			unsigned EA      : 1;
			unsigned CR      : 1;
			unsigned DLCI    : 6;
		} ATTR_PACKED RFCOMM_Address_t;

		typedef struct
		{
			RFCOMM_Address_t Address;
			uint8_t          Control;
		} ATTR_PACKED RFCOMM_Header_t;

		typedef struct
		{
			unsigned EA      : 1;
			unsigned CR      : 1;
			unsigned Command : 6;
		} ATTR_PACKED RFCOMM_Command_t;

		typedef struct
		{
			uint8_t  DLCI;
			unsigned FrameType           : 4;
			unsigned ConvergenceLayer    : 4;
			uint8_t  Priority;
			uint8_t  ACKTimerTicks;
			uint16_t MaximumFrameSize;
			uint8_t  MaxRetransmissions;
			uint8_t  RecoveryWindowSize;
		} ATTR_PACKED RFCOMM_PN_Parameters_t;

		typedef struct
		{
			RFCOMM_Address_t Address;
			uint8_t          Signals;
		} ATTR_PACKED RFCOMM_MSC_Parameters_t;

		typedef struct
		{
			RFCOMM_Address_t    Address;
			RFCOMM_PortConfig_t Params;
		} ATTR_PACKED RFCOMM_RPN_Parameters_t;

		typedef struct
		{
			BT_StackConfig_t*   Stack;
			BT_L2CAP_Channel_t* ACLChannel;

			uint8_t DLCI;
			uint8_t State;
			uint8_t ConfigFlags;

			struct
			{
				uint8_t  Priority;
				uint16_t MTU;
				uint8_t  LocalSignals;
				uint8_t  RemoteSignals;
			} ATTR_PACKED DataLink;

			RFCOMM_PortConfig_t PortConfig;
		} RFCOMM_Channel_t;

	/* Function Prototypes: */
		void RFCOMM_Init(BT_StackConfig_t* const StackState);
		void RFCOMM_Manage(BT_StackConfig_t* const StackState);
		void RFCOMM_ChannelOpened(BT_StackConfig_t* const StackState,
		                          BT_L2CAP_Channel_t* const Channel);
		void RFCOMM_ChannelClosed(BT_StackConfig_t* const StackState,
		                          BT_L2CAP_Channel_t* const Channel);
		void RFCOMM_ProcessPacket(BT_StackConfig_t* const StackState,
                                  BT_L2CAP_Channel_t* const Channel,
                                  const uint16_t Length,
                                  uint8_t* Data);
		bool RFCOMM_SendData(RFCOMM_Channel_t* const RFCOMMChannel,
                             const uint16_t DataLen,
                             const void* Data);

		void EVENT_RFCOMM_ChannelStateChange(BT_StackConfig_t* const StackState,
		                                     RFCOMM_Channel_t* const Channel);

		void CALLBACK_RFCOMM_DataReceived(BT_StackConfig_t* const StackState,
		                                  RFCOMM_Channel_t* const Channel,
		                                  uint16_t Length,
		                                  uint8_t* Data);
#endif
