abcminiuser/explorerbot/Code/USB/BluetoothAdapter.c

/*
             Bluetooth Robot
     Copyright (C) Dean Camera, 2011.

  dean [at] fourwalledcubicle [dot] com
        www.fourwalledcubicle.com
*/

/*
  Copyright 2011  Dean Camera (dean [at] fourwalledcubicle [dot] com)

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
  The author disclaim all warranties with regard to this
  software, including all implied warranties of merchantability
  and fitness.  In no event shall the author be liable for any
  special, indirect or consequential damages or any damages
  whatsoever resulting from loss of use, data or profits, whether
  in an action of contract, negligence or other tortious action,
  arising out of or in connection with the use or performance of
  this software.
*/

/** \file
 *
 *  USB transport management for USB Bluetooth adapters.
 */

#include "BluetoothAdapter.h"

/** Bluetooth stack configuration and state stable, used to configure an instance of the Bluetooth stack. */
static BT_StackConfig_t BluetoothAdapter_Stack =
	{
		.Config = 
			{
				.Class              = (DEVICE_CLASS_SERVICE_CAPTURING | DEVICE_CLASS_MAJOR_COMPUTER | DEVICE_CLASS_MINOR_COMPUTER_PALM),
				.Name               = "Bluetooth Robot",
				.PINCode            = "0000",
				.Discoverable       = true,
				.PacketBuffer       = EXTERNAL_MEMORY_START,
			}
	};

/** Indicates if the Bluetooth control mode is currently active or not */
bool BluetoothAdapter_IsActive;

/** Last connected Bluetooth adapter BDADDR, stored in EEPROM */
BDADDR_t BluetoothAdapter_LastLocalBDADDR EEMEM;

/** Bluetooth BDADDR of a device to connect to on demand, stored in EEPROM */
BDADDR_t BluetoothAdapter_RemoteBDADDR EEMEM;


/** Attempts to configure the system pipes for the attached Bluetooth adapter.
 *
 *  \param[in] DeviceDescriptor      Pointer to the Device Descriptor read from the attached device
 *  \param[in] ConfigDescriptorSize  Size of the retrieved Configuration Descriptor from the device
 *  \param[in] ConfigDescriptorData  Pointer to the Configuration Descriptor read from the attached device
 *
 *  \return  Boolean true if a valid Bluetooth interface was found, false otherwise.
 */
bool BluetoothAdapter_ConfigurePipes(USB_Descriptor_Device_t* const DeviceDescriptor,
                                     uint16_t ConfigDescriptorSize,
                                     void* ConfigDescriptorData)
{
	USB_Descriptor_Endpoint_t* DataINEndpoint  = NULL;
	USB_Descriptor_Endpoint_t* DataOUTEndpoint = NULL;
	USB_Descriptor_Endpoint_t* EventsEndpoint  = NULL;
	
	BluetoothAdapter_IsActive = false;

	/* Validate returned device Class, SubClass and Protocol values against the Bluetooth spec values */
	if ((DeviceDescriptor->Class    != BLUETOOTH_DEVICE_CLASS)    ||
	    (DeviceDescriptor->SubClass != BLUETOOTH_DEVICE_SUBCLASS) ||
	    (DeviceDescriptor->Protocol != BLUETOOTH_DEVICE_PROTOCOL))
	{
		return false;
	}

	/* The Bluetooth USB transport addendum mandates that the data (not streaming voice) endpoints
	   be in the first interface descriptor (interface 0) */
	USB_GetNextDescriptorOfType(&ConfigDescriptorSize, &ConfigDescriptorData, DTYPE_Interface);

	/* Ensure that an interface was found, and the end of the descriptor was not reached */
	if (!(ConfigDescriptorSize))
	  return false;

	while (!(DataINEndpoint) || !(DataOUTEndpoint) || !(EventsEndpoint))
	{
		/* Get the next Bluetooth interface's data endpoint descriptor */
		if (USB_GetNextDescriptorComp(&ConfigDescriptorSize, &ConfigDescriptorData,
		                              DComp_NextInterfaceBluetoothDataEndpoint) != DESCRIPTOR_SEARCH_COMP_Found)
		{
			/* Data endpoints not found within the first bluetooth device interface, error out */
			return false;
		}

		/* Retrieve the endpoint address from the endpoint descriptor */
		USB_Descriptor_Endpoint_t* EndpointData = DESCRIPTOR_PCAST(ConfigDescriptorData, USB_Descriptor_Endpoint_t);

		uint8_t EndpointType = (EndpointData->Attributes & EP_TYPE_MASK);

		/* If the endpoint is a IN type endpoint */
		if ((EndpointData->EndpointAddress & ENDPOINT_DIR_MASK) == ENDPOINT_DIR_IN)
		{	
			/* Check if the found endpoint is a interrupt or bulk type descriptor */
			if (EndpointType == EP_TYPE_BULK)
			  DataINEndpoint = EndpointData;
			else if (EndpointType == EP_TYPE_INTERRUPT)
			  EventsEndpoint = EndpointData;
		}
		else
		{
			if (EndpointType == EP_TYPE_BULK)
			  DataOUTEndpoint = EndpointData;
		}
	}

	/* Configure the Bluetooth data IN pipe */
	Pipe_ConfigurePipe(BLUETOOTH_DATA_IN_PIPE, EP_TYPE_BULK, PIPE_TOKEN_IN,
	                   DataINEndpoint->EndpointAddress, DataINEndpoint->EndpointSize, PIPE_BANK_SINGLE);

	/* Configure the Bluetooth data OUT pipe */
	Pipe_ConfigurePipe(BLUETOOTH_DATA_OUT_PIPE, EP_TYPE_BULK, PIPE_TOKEN_OUT,
					   DataOUTEndpoint->EndpointAddress, DataOUTEndpoint->EndpointSize, PIPE_BANK_SINGLE);

	/* Configure the Bluetooth events pipe */
	Pipe_ConfigurePipe(BLUETOOTH_EVENTS_PIPE, EP_TYPE_INTERRUPT, PIPE_TOKEN_IN,
					   EventsEndpoint->EndpointAddress, EventsEndpoint->EndpointSize, PIPE_BANK_SINGLE);
	Pipe_SetInterruptPeriod(EventsEndpoint->PollingIntervalMS);

	BluetoothAdapter_IsActive = true;
	return true;
}

/** Descriptor comparator function. This comparator function is can be called while processing an attached USB device's
 *  configuration descriptor, to search for a specific sub descriptor. It can also be used to abort the configuration
 *  descriptor processing if an incompatible descriptor configuration is found.
 *
 *  This comparator searches for the next Endpoint descriptor inside the current interface descriptor, aborting the
 *  search if another interface descriptor is found before the required endpoint.
 *
 *  \param[in] CurrentDescriptor  Pointer to the current descriptor being examined.
 *
 *  \return A value from the DSEARCH_Return_ErrorCodes_t enum
 */
uint8_t DComp_NextInterfaceBluetoothDataEndpoint(void* CurrentDescriptor)
{
	USB_Descriptor_Header_t* Header = DESCRIPTOR_PCAST(CurrentDescriptor, USB_Descriptor_Header_t);

	/* Determine the type of the current descriptor */
	if (Header->Type == DTYPE_Endpoint)
	  return DESCRIPTOR_SEARCH_Found;
	else if (Header->Type == DTYPE_Interface)
	  return DESCRIPTOR_SEARCH_Fail;
	else
	  return DESCRIPTOR_SEARCH_NotFound;
}

/** Performs any post configuration tasks after the attached Bluetooth adapter has been successfully enumerated.
 *
 *  \return Boolean true if no Bluetooth adapter attached or if all post-configuration tasks complete without error, false otherwise
 */
bool BluetoothAdapter_PostConfiguration(void)
{
	if (!(BluetoothAdapter_IsActive))
	  return true;
	  
	Bluetooth_Init(&BluetoothAdapter_Stack);
	return true;
}

/** Attempts a connection to the remote device whose address has been stored internally.
 *
 *  \return Created HCI connection handle for the new connection.
 */
BT_HCI_Connection_t* BluetoothAdapter_ConnectToRemoteDevice(void)
{
	BDADDR_t RemoteBDADDR;
	
	/* Retrieve the remote device's BDADDR saved in EEPROM, attempt a connection */
	eeprom_read_block(RemoteBDADDR, BluetoothAdapter_RemoteBDADDR, sizeof(BDADDR_t));
	return Bluetooth_HCI_Connect(&BluetoothAdapter_Stack, RemoteBDADDR, LINK_TYPE_ACL);
}

/** Task to manage an enumerated USB Bluetooth adapter once connected, to display movement data as it is received. */
void BluetoothAdapter_USBTask(void)
{
	if ((USB_HostState != HOST_STATE_Configured) || !(BluetoothAdapter_IsActive))
	  return;

	Pipe_SelectPipe(BLUETOOTH_DATA_IN_PIPE);
	Pipe_Unfreeze();
	
	if (Pipe_IsINReceived())
	{
		BT_HCIData_Header_t* PacketHeader = (BT_HCIData_Header_t*)BluetoothAdapter_Stack.Config.PacketBuffer;

		/* Read in the HCI Data packet data from the Data IN pipe */
		Pipe_Read_Stream_LE(PacketHeader, sizeof(BT_HCIData_Header_t), NULL);
		Pipe_Read_Stream_LE(PacketHeader->Data, PacketHeader->DataLength, NULL);
		Pipe_ClearIN();
		Pipe_Freeze();

		RGB_SetColour(RGB_ALIAS_Busy);
		Bluetooth_ProcessPacket(&BluetoothAdapter_Stack, BLUETOOTH_PACKET_HCIData);
		RGB_SetColour(RGB_ALIAS_Connected);
	}
	
	Pipe_Freeze();
	
	Pipe_SelectPipe(BLUETOOTH_EVENTS_PIPE);
	Pipe_Unfreeze();
	
	if (Pipe_IsINReceived())
	{
		BT_HCIEvent_Header_t* EventHeader = (BT_HCIEvent_Header_t*)BluetoothAdapter_Stack.Config.PacketBuffer;

		/* Read in the HCI Event packet data from the Event IN pipe */
		Pipe_Read_Stream_LE(EventHeader, sizeof(BT_HCIEvent_Header_t), NULL);
		Pipe_Read_Stream_LE(EventHeader->Parameters, EventHeader->ParameterLength, NULL);
		Pipe_ClearIN();
		Pipe_Freeze();

		RGB_SetColour(RGB_ALIAS_Busy);
		Bluetooth_ProcessPacket(&BluetoothAdapter_Stack, BLUETOOTH_PACKET_HCIEvent);
		RGB_SetColour(RGB_ALIAS_Connected);
	}
	
	Pipe_Freeze();
	
	/* Keep on running the management routine until all pending packets have been sent */	
	while (Bluetooth_ManageConnections(&BluetoothAdapter_Stack))
	  RGB_SetColour(RGB_ALIAS_Busy);

	RGB_SetColour(RGB_ALIAS_Connected);
}

/** Manages timeouts within the Bluetooth stack, each time the stack's tick interval has expired. */
void BluetoothAdapter_TickElapsed(void)
{
	if ((USB_HostState != HOST_STATE_Configured) || !(BluetoothAdapter_IsActive))
	  return;
	  
	Bluetooth_TickElapsed(&BluetoothAdapter_Stack);
}

void CALLBACK_Bluetooth_SendPacket(BT_StackConfig_t* const StackState,
                                   const uint8_t Type,
                                   const uint16_t Length)
{
	RGB_SetColour(RGB_ALIAS_Busy);

	/* Determine the type of packet being sent, use appropriate pipe */
	switch (Type)
	{
		case BLUETOOTH_PACKET_HCICommand:		
			USB_ControlRequest = (USB_Request_Header_t)
				{
					.bmRequestType = (REQDIR_HOSTTODEVICE | REQTYPE_CLASS | REQREC_DEVICE),
					.bRequest      = 0,
					.wValue        = 0,
					.wIndex        = 0,
					.wLength       = Length
				};

			/* HCI commands must be sent over the Control pipe */
			Pipe_SelectPipe(PIPE_CONTROLPIPE);
			USB_Host_SendControlRequest(StackState->Config.PacketBuffer);
			break;
		case BLUETOOTH_PACKET_HCIData:
			Pipe_SelectPipe(BLUETOOTH_DATA_OUT_PIPE);

			/* HCI data packets must be sent over the Data OUT pipe */
			Pipe_Unfreeze();
			Pipe_Write_Stream_LE(StackState->Config.PacketBuffer, Length, NULL);
			Pipe_ClearOUT();
			Pipe_Freeze();
			break;
	}

	RGB_SetColour(RGB_ALIAS_Connected);
}

void EVENT_Bluetooth_InitComplete(BT_StackConfig_t* const StackState)
{
	/* Save the local BDADDR of the connected Bluetooth adapter for later use */
	eeprom_update_block(BluetoothAdapter_Stack.State.HCI.LocalBDADDR, BluetoothAdapter_LastLocalBDADDR, sizeof(BDADDR_t));
}
