abcminiuser/explorerbot/Code/LUFA/Drivers/Board/UC3/EVK1104/LEDs.h

/*
             LUFA Library
     Copyright (C) Dean Camera, 2011.
              
  dean [at] fourwalledcubicle [dot] com
      www.fourwalledcubicle.com
*/

/*
  Copyright 2011  Dean Camera (dean [at] fourwalledcubicle [dot] com)

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
  The author disclaim all warranties with regard to this
  software, including all implied warranties of merchantability
  and fitness.  In no event shall the author be liable for any
  special, indirect or consequential damages or any damages
  whatsoever resulting from loss of use, data or profits, whether
  in an action of contract, negligence or other tortious action,
  arising out of or in connection with the use or performance of
  this software.
*/

/** \file
 *  \brief Board specific LED driver header for the Atmel EVK1104.
 *  \copydetails Group_LEDs_EVK1104
 *
 *  \note This file should not be included directly. It is automatically included as needed by the LEDs driver
 *        dispatch header located in LUFA/Drivers/Board/LEDs.h.
 */

/** \ingroup Group_LEDs
 *  \defgroup Group_LEDs_EVK1104 EVK1104
 *  \brief Board specific LED driver header for the Atmel EVK1104.
 *
 *  Board specific LED driver header for the Atmel EVK1104.
 *
 *  @{
 */

#ifndef __LEDS_EVK1104_H__
#define __LEDS_EVK1104_H__

	/* Includes: */
		#include "../../../../Common/Common.h"

	/* Enable C linkage for C++ Compilers: */
		#if defined(__cplusplus)
			extern "C" {
		#endif

	/* Preprocessor Checks: */
		#if !defined(__INCLUDE_FROM_LEDS_H)
			#error Do not include this file directly. Include LUFA/Drivers/Board/LEDS.h instead.
		#endif

	/* Private Interface - For use in library only: */
	#if !defined(__DOXYGEN__)
		/* Macros: */
			#define LEDS_LEDMASK2    (1UL << 3)
			#define LEDS_LEDMASK3   ((1UL << 9) | (1UL << 6) | (1UL << 5))
	#endif

	/* Public Interface - May be used in end-application: */
		/* Macros: */
			/** LED mask for the first LED on the board. */
			#define LEDS_LED1        (1UL << 3)

			/** LED mask for the second LED on the board. */
			#define LEDS_LED2        (1UL << 5)

			/** LED mask for the third LED on the board. */
			#define LEDS_LED3        (1UL << 9)

			/** LED mask for the fourth LED on the board. */
			#define LEDS_LED4        (1UL << 6)

			/** LED mask for all the LEDs on the board. */
			#define LEDS_ALL_LEDS    (LEDS_LED1 | LEDS_LED2 | LEDS_LED3 | LEDS_LED4)

			/** LED mask for the none of the board LEDs */
			#define LEDS_NO_LEDS     0

		/* Inline Functions: */
		#if !defined(__DOXYGEN__)
			static inline void LEDs_Init(void)
			{
				AVR32_GPIO.port[2].gpers = LEDS_LEDMASK2;
				AVR32_GPIO.port[2].oders = LEDS_LEDMASK2;
				AVR32_GPIO.port[2].ovrs  = LEDS_LEDMASK2;

				AVR32_GPIO.port[3].gpers = LEDS_LEDMASK3;
				AVR32_GPIO.port[3].oders = LEDS_LEDMASK3;
				AVR32_GPIO.port[3].ovrs  = LEDS_LEDMASK3;
			}
			
			static inline void LEDs_TurnOnLEDs(const uint32_t LEDMask)
			{
				AVR32_GPIO.port[2].ovrc  = (LEDMask & LEDS_LEDMASK2);
				AVR32_GPIO.port[3].ovrc  = (LEDMask & LEDS_LEDMASK3);
			}

			static inline void LEDs_TurnOffLEDs(const uint32_t LEDMask)
			{
				AVR32_GPIO.port[2].ovrs  = (LEDMask & LEDS_LEDMASK2);
				AVR32_GPIO.port[3].ovrs  = (LEDMask & LEDS_LEDMASK3);
			}

			static inline void LEDs_SetAllLEDs(const uint32_t LEDMask)
			{
				AVR32_GPIO.port[2].ovrs  = LEDS_LEDMASK2;
				AVR32_GPIO.port[2].ovrc  = (LEDMask & LEDS_LEDMASK2);

				AVR32_GPIO.port[3].ovrs  = LEDS_LEDMASK3;
				AVR32_GPIO.port[3].ovrc  = (LEDMask & LEDS_LEDMASK3);
			}
			
			static inline void LEDs_ChangeLEDs(const uint32_t LEDMask, const uint32_t ActiveMask)
			{
				AVR32_GPIO.port[2].ovrs  = (LEDMask    & LEDS_LEDMASK2);
				AVR32_GPIO.port[2].ovrc  = (ActiveMask & LEDS_LEDMASK2);

				AVR32_GPIO.port[3].ovrs  = (LEDMask    & LEDS_LEDMASK3);
				AVR32_GPIO.port[3].ovrc  = (ActiveMask & LEDS_LEDMASK3);
			}

			static inline void LEDs_ToggleLEDs(const uint32_t LEDMask)
			{
				AVR32_GPIO.port[2].ovrt  = (LEDMask & LEDS_LEDMASK2);
				AVR32_GPIO.port[3].ovrt  = (LEDMask & LEDS_LEDMASK3);
			}
			
			static inline uint32_t LEDs_GetLEDs(void) ATTR_WARN_UNUSED_RESULT;
			static inline uint32_t LEDs_GetLEDs(void)
			{
				return ((~AVR32_GPIO.port[2].ovr & LEDS_LEDMASK2) | (~AVR32_GPIO.port[3].ovr & LEDS_LEDMASK3));
			}
		#endif

	/* Disable C linkage for C++ Compilers: */
		#if defined(__cplusplus)
			}
		#endif
		
#endif

/** @} */
