abcminiuser/explorerbot/Code/LUFA/Drivers/USB/Core/Events.h

/*
             LUFA Library
     Copyright (C) Dean Camera, 2011.

  dean [at] fourwalledcubicle [dot] com
           www.lufa-lib.org
*/

/*
  Copyright 2011  Dean Camera (dean [at] fourwalledcubicle [dot] com)

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
  The author disclaim all warranties with regard to this
  software, including all implied warranties of merchantability
  and fitness.  In no event shall the author be liable for any
  special, indirect or consequential damages or any damages
  whatsoever resulting from loss of use, data or profits, whether
  in an action of contract, negligence or other tortious action,
  arising out of or in connection with the use or performance of
  this software.
*/

/** \file
 *  \brief USB Event management definitions.
 *  \copydetails Group_Events
 *
 *  \note This file should not be included directly. It is automatically included as needed by the USB driver
 *        dispatch header located in LUFA/Drivers/USB/USB.h.
 */

/** \ingroup Group_USB
 *  \defgroup Group_Events USB Events
 *  \brief USB Event management definitions.
 *
 *  This module contains macros and functions relating to the management of library events, which are small
 *  pieces of code similar to ISRs which are run when a given condition is met. Each event can be fired from
 *  multiple places in the user or library code, which may or may not be inside an ISR, thus each handler
 *  should be written to be as small and fast as possible to prevent possible problems.
 *
 *  Events can be hooked by the user application by declaring a handler function with the same name and parameters
 *  listed here. If an event with no user-associated handler is fired within the library, it by default maps to an
 *  internal empty stub function.
 *
 *  Each event must only have one associated event handler, but can be raised by multiple sources by calling the
 *  event handler function (with any required event parameters).
 *
 *  @{
 */
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
