abcminiuser/explorerbot/(commit log)

2011-08-02 Initial commit - using JoystickHostWithParser as a base for the main application.
    [ConfiguringApps.txt]
2011-08-02 Add dummy RGB LED and motor drivers.
    Split out Joystick Host management code from the main application source to a separate set of files, to isolate the functionality from the Bluetooth management code.
    Adjust Joystick host parser to control the robot motors from the current joystick position.
2011-08-02 Add additional dummy hardware drivers for the robot headlights, LCD and Speaker.
2011-08-02 Add dummy driver for the board Buttons.c
    Add test start-up sequence using the LCD to display the project name and author.
2011-08-02 Add Sensors hardware driver.
    Implement RGB, Headlights, Motors and Buttons drivers.
    Partially implement LCD and Sensors drivers.
2011-08-02 Update LCD backlight PWM code to correctly turn off the backlight when a zero intensity is given.
    Implement Speaker hardware driver.
    [BluetoothRobot.c, LCD.c, Speaker.c, Speaker.h]
2011-08-03 Add External SRAM control driver.
    Add stub Bluetooth Host control driver.
    Update Joystick Control driver to optionally allow for mouse control as well as joysticks. Make the joystick driver set the RGB LED to the connected state when a compatible HID device is inserted.
    Complete initial revision of the HD44780 LCD driver.
    Generalize RGB LED alises to allow for connected/busy indication of any control system, not just Bluetooth.
2011-08-03 Add Bluetooth USB adapter enumeration code.
    Add LCD error messages to the USB event callbacks.
    [BluetoothControl.c, BluetoothControl.h, BluetoothRobot.c, JoystickControl.c]
2011-08-17 Adjust startup routine to display the welcome message before fading in the LCD backlight. Remove tone on startup.
    Display current USB mode on the LCD once a USB device has been successfully enumerated.
2011-08-17 Make the first joystick/mouse button control the robot headlights.
    Change the joystick motor control system to use a digital speed (on or off, in either direction) rather than an analogue speed.
2011-08-17 Lower LCD backlight PWM timer prescaler. Turn on display during LCD startup routine to ensure it is ready for data to display.
2011-08-17 Correct RGB status light enum mappings to match the LEDs on the board.
    [RGB.c, RGB.h]
2011-08-17 Oops - fix incorrect port initialization in the Sensors hardware driver.
    [Sensors.c]
2011-08-17 Fix motor driver - enforce motor stoppage before reversing direction to prevent overcurrent condition.
    [Motors.c, Motors.h]
2011-08-18 Stop all motors in the event of a USB disconnection or a USB controller failure.
    Add reset/e-stop control via the board buttons.
    Split out startup sequence into a separate function, add RGB LED control to the startup sequence.
    Allow partial parsing of HID devices in the HID control mode, if the HID parser table becomes full.
    [BluetoothRobot.c, BluetoothRobot.h, JoystickControl.c, Speaker.c]
2011-08-18 Remove power issue workarounds in the motor controller, solved on the board hardware with a bulk capacitor on the power input to prevent undervoltage conditions.
    [Motors.c]
2011-08-18 Remove old LUFA trunk.
    [ConfiguringApps.txt]
2011-08-18 Adjust motor controller to use a faster PWM frequency, to prevent overcurrent of the motor.
    [BluetoothRobot.c, Motors.c]
2011-08-22 Add sensor init and ID verification routines.
    Switch HID control to use the joystick buttons, instead of the X and Y axis.
    Force motor PWM lines low as a safety measure if power to motors stopped.
    Turn off unused peripherals to save power via the Power Reduction registers.
2011-08-24 Move out sensors init code to a separate routine inside the main program, so that it can be disabled easily if not required.
    Remove unnecessary ALLOW_MOUSE_CONTROL compile time option.
2011-08-24 Start Bluetooth stack; begin HCI packet processing, add dummy ACL processing routines. Update BluetoothControl module to correctly read in and send out Bluetooth HCI and ACL packets.
    [Bluetooth.c, Bluetooth.h, BluetoothClassCodes.h, BluetoothCommon.h, BluetoothControl.c, BluetoothControl.h, BluetoothHCI.c]
2011-08-24 Make Bluetooth stack take in a configuration/state struct, to allow for future expansion (multiple adapters).
    Implement HCI initialization of the adapter to allow for device discovery.
2011-08-24 Add sensor register definition header files.
2011-08-25 Implement Bluetooth HCI connection and disconnection management code.
    Add function documentation to the robot hardware drivers.
    Add Doxygen configuration file.
2011-08-29 Partial ACL layer implementation of several commands.
    Remove Bluetooth_HCI_CloseConnection() in favour of manual connection free marking.
    Correct corrupted ACL data transport to the Bluetooth adapter.
    Add new LCD_WriteFormattedString() convenience function to the LCD driver.
    [BluetoothCommon.h, BluetoothControl.c, BluetoothHCI.c, BluetoothHCI.h, LCD.c, LCD.h]
2011-08-29 Add missing ACL signalling command processing routines.
    Add PIN CODE and LINK KEY request processing to the HCI layer - NAK request for the PIN KEY if one is not given in the stack configuration.
    Add HCI connection destruction notification to the ACL layer, so that channels associated with the destroyed connection can be closed.
    Re-map unknown device error RGB led code to the general error LED code, so that Magenta can be used for packet processing/system busy.
    [BluetoothCommon.h, BluetoothControl.c, BluetoothHCI.c, BluetoothHCI.h, BluetoothHCIPacketTypes.h, BluetoothRobot.c, RGB.h]
2011-08-30 Fix new ACL channels not having the HCI connection handle stored correctly in the channel table.
    Fix incorrect channel lookup for ACL CONFIG REQUEST commands.
    [BluetoothControl.c]
2011-08-30 Add missing endianness corrections to the ACL layer for Big Endian devices.
    Add channel PSM codes, so that the channel protocol can be identified in the user application.
    [BluetoothCommon.h]
2011-08-31 Correct headers in all source files to use correct website URL.
    Add missing ACL signal code header file to the Bluetooth stack.
    Add SDP Bluetooth service stub.
    [BMA150.h, BMP085.h, Bluetooth.c, Bluetooth.h, BluetoothClassCodes.h, BluetoothCommon.h]
2011-08-31 Move sensor driver code into a new sensors folder, for better organisation of related sensor drivers.
2011-08-31 Add AK8975 sensor driver.
    Update sensor platform to use seperate drivers for each sensor, with a common structure to hold all sensor's current values.
    Use timer 3 to update the current sensor values at a rate of 4Hz.
    Show the status of all sensors on startup to the user using custom LCD icons.
2011-08-31 Switch to C-style comments only, instead of mixed C++/C style comments.
2011-08-31 Add sensor driver files for the rest of the board sensors - add ID checks for each sensor to ensure the sensor is connected and functional.
    Fix incorrect flag check in the sensor update timer.
    [AK8975.c, BMA150.c, BMA150.h, BMP085.c, BMP085.h, BluetoothRobot.c, ITG3200.c, ITG3200.h]
2011-08-31 Implement ITG3200 sensor driver.
    Increase TWI bus frequency and clean up the AK8975 sensor driver.
2011-08-31 Implement raw BMA150 and BMP085 sensor drivers.
2011-08-31 Add zero calibration to the ITG3200 sensor on startup.
    Enabled and use sensor End Of Conversion interrupt lines to detect the end of the next sensor data conversion.
2011-09-01 Force reset of the BMP085 pressure sensor on sensor initialization.
    Add temperature sensor information struct parameter to the ITG3200 initialization routine, so that the pseudo-sensor's Connected state can be updated to reflect the physical sensor.
    [BMP085.c, ITG3200.c, ITG3200.h, Sensors.c]
2011-09-01 Add support to the LCD driver for embedded newlines in the display text, to automatically select the second line of the display.
2011-09-01 Make LCD_SetCustomChar() accept character tables stored in FLASH, not SRAM.
    Wrap Sensor TWI packet reads and writes into new Sensor_ReadBytes() and Sensor_WriteBytes() functions, so that the timeout can be specified in one place and to reduce code noise.
    Increase TWI bus speed to 200KHz.
    [AK8975.c, AK8975.h, BMA150.c, BMA150.h, BMP085.c, BMP085.h, BluetoothRobot.c, ITG3200.c]
2011-09-01 Make sure the sensors init routine doesn't lock up if the gyroscope isn't connected, in the ITG3200 zero calibration routine. Lower sensor communication timeout to 10ms instead of 100ms per sensor.
    [ITG3200.c, ITG3200.h, Sensors.c, SensorsCommon.h]
2011-09-04 Update sensors platform to use the new LUFA macro TWI_BITLENGTH_FROM_FREQ() for the TWI bit length calculations.
    Correct display of BDADDR addresses - should be displayed in Big Endian.
    Update long delays to use a single call to the Delay_MS(), which has been expanded in the latest LUFA to support 16-bit delay periods.
    [BluetoothControl.c, BluetoothRobot.c, Sensors.c, SensorsCommon.h]
2011-09-04 Fix HCI layer writing corrupt packets in response to a PIN and Link Key request.
    [BluetoothCommon.h, BluetoothHCI.c]
2011-09-04 Change the PIN code request HCI command handler to use strlcpy() instead of memcpy() to prevent leakage of RAM contents in the unused bytes.
    Add additional comments to HCI/ACL functions.
    Add const qualifier to the returned handle objects on the HCI and ACL connection/channel creation and search routines.
    [BluetoothHCI.c, BluetoothHCI.h]
2011-09-04 Add start of the HID Bluetooth service layer.
    Add dummy SDP layer which just returns no services when a SSA request is issued.
    Add HID/SDP service channel open/close notification functions.
    Increase motor power to increase robot driving torque.
    [BluetoothCommon.h, BluetoothControl.c, BluetoothControl.h, BluetoothL2CAP.c]
2011-09-06 Add headlight and speaker control to the USB HID and Bluetooth HID controller code.
    Alter Motors_SetChannelSpeed() to take in both channel value simultaneously rather than requiring two calls to set each channel to a different speed.
    Fix speaker driver varying duty cycle, and not frequency of the generated tone.
    [BluetoothControl.c, BluetoothControl.h, BluetoothRobot.c, ExternalSRAM.c, JoystickControl.c, Motors.c, Motors.h, Speaker.c]
2011-09-06 Make speaker and LCD PWM update function static inline for speed/compactness.
    Add a delay to the motors when changing a channel's direction to prevent voltage dips on the rails due to slow inverter transistors on the H-Bridge IC.
    [BluetoothControl.c, JoystickControl.c, LCD.c, LCD.h, Motors.c, Speaker.c, Speaker.h]
2011-09-07 Increase PWM frequency of the robot motors to gain a little speed and move the frequency outside the audible range.
    Remove unused SDPServices.c/SDPServices.h files for now.
2011-09-07 Add EVENT_Bluetooth_InitComplete() event callback to the Bluetooth stack.
    Add support for PS3 controllers, including both tethered HID control and pairing to the last inserted Bluetooth adapter.
    Cache HID report items in the HID Joystick control module, to decrease report processing latency and to allow for easy remapping of keys to robot functions.
    Rename BluetoothAdapter module contents to use the correct module prefix.
    [BluetoothAdapter.c, BluetoothAdapter.h, BluetoothCommon.h, BluetoothHCI.c, BluetoothRobot.c, JoystickHID.c]
2011-09-08 Swap motor channels to reflect the physical hardware connections.
    [BluetoothControl.c, JoystickHID.c, Motors.c]
2011-09-08 Document motor driver channel update function code.
2011-09-08 Correct EEPROM storage of last inserted Bluetooth adapter BDADDR.
    Fix broken SDP server NULL responses to service requests.
    [BluetoothAdapter.c, JoystickHID.c]
2011-09-09 Remove redundant service header files.
    Add ability to register and de-register service attribute tables with the SDP service.
2011-09-09 Ensure RFCOMM SDP table entries are endian-corrected for the current architecture.
    Minor code cleanup.
    [RFCOMM.c, RFCOMMServiceTable.c, SDP.c]
2011-09-11 Add sensor name and axis output information to the sensor platform.
2011-09-11 Add ability to log sensor data to an attached USB Mass Storage drive using the FATFs library.
2011-09-11 Fail HID mode if no suitable report items are found, now that report items are filtered in the HID report parser callback routine.
    Document DataLoggerMS module routines.
    [BluetoothRobot.c, DataLoggerMS.c, JoystickHID.c]
2011-09-11 Move board hardware drivers into a new "Hardware" subdirectory to keep them grouped together.
2011-09-12 Oops - FATFs library won't report a file exist error if FA_OPEN_ALWAYS is used. Switch to FA_CREATE_NEW to be able to detect if the log file already exists, and open it explicitly if so.
    [DataLoggerMS.c, DataLoggerMS.h]
2011-09-12 Remove mapping to the PS3 button, and perform the PS3 pairing as part of the controller set-up and initialisation. Fix PS3 report generation request.
    [JoystickHID.c]
2011-09-12 Correct formatting of raw BMA150 sensor data, as it is 10-bit and not 16-bit.
    [BMA150.c, DataLoggerMS.c]
2011-09-12 Add latest LUFA trunk.
    [ConfiguringApps.txt]
2011-09-12 Rename Hardware folder to Drivers folder, in preparation of hardware schematics/board files to be committed.
2011-09-12 Add board hardware schematics and board design.
    [AVRController.SchDoc, AtmelSensorBoards.PcbLib, AtmelSensorBoards.SchLib, Dual-In-Line Package.PcbLib, IPC-SM-782 Section 8.1 Chip Resistor.PcbLib, IPC-SM-782 Section 9.3 SOP.PcbLib, Latrobe.PCBLIB, Latrobe.SCHLIB]
2011-09-14 Fix HID report mappings for the PS3 controller.
    [JoystickHID.c]
2011-09-14 Add temporary fixed parser for Bluetooth PS3 controller reports.
    [BluetoothControl.c]
2011-09-14 Ensure attached Mass Storage device is properly reset in the event of a failed disk read or write command.
    [LCD.c]
2011-09-14 Remove test HID mouse mappings. Add aliases for the various PS3 controller button usages.
2011-09-14 Correct PS3 controller Bluetooth pairing packet's ordering of the adapter BDADDR.
    [JoystickHID.c]
2011-09-17 Remove temporary header include from the robot USB HID driver.
2011-09-17 Apply fixes to the USB HID parser and HID host class driver from LUFA trunk.
    [HID.c, HIDParser.c, JoystickHID.c]
2011-09-19 Fix Bluetooth L2CAP Configuration Request channel search request, so that the correct local channel number is searched for, and not the remote channel number.
    [BluetoothControl.c, BluetoothL2CAP.c, BluetoothL2CAP.h]
2011-09-22 Fix base UUID in the SDP service, so that service UUIDs are correctly reported upon request.
    Reset temporary channel handles in the HID service once the magic PS3 controller packet has been sent.
    [SDP.c, SDPServiceTable.h]
2011-09-22 Fix Doxygen documentation errors and namespace the SDP service definitions.
    [BluetoothCommon.h, RFCOMMServiceTable.c, RFCOMMServiceTable.h, SDP.c, SDP.h, SDPServiceTable.h]
2011-09-26 Add novelty horn button, latched headlights button to wired HID control mode.
2011-09-26 Add novelty hornAdd novelty horn button, latched headlights button to wired and wireless HID control mode.
2011-09-26 Fix L2CAP locally initiated connections to remote devices.
    Add Wiimote support.
    Add connection/disconnection tones.
    [BluetoothControl.c, BluetoothL2CAP.c, BluetoothL2CAPSignalCodes.h, Speaker.c, Speaker.h]
2011-09-27 Read off remote BDADDR to connect to on demand from the attached Mass Storage disk.
    Make button 2 on the board enable sensor logging when in Mass Storage mode.
2011-09-27 Create remote Bluetooth device BDADDR file on the attached Mass Storage disk if it is missing.
    [DataLoggerMS.c]
2011-09-27 Add Bluetooth connection failed callback and sound/notification.
    Add convenience function to the LCD driver to print out Bluetooth device addresses.
    [BluetoothControl.c, BluetoothHCI.c, BluetoothRobot.c, LCD.c, LCD.h, Speaker.c, Speaker.h]
2011-09-27 Add LCD message during device configuration.
2011-09-28 Add LCD_WriteFormattedString_P() function to the LCD driver.
    Ensure all constant strings are stored in PROGMEM rather than read out to SRAM on startup.
    Add missing EVENT_Bluetooth_ConnectionFailed() prototype.
    [BluetoothCommon.h, BluetoothControl.c, BluetoothRobot.c, LCD.c, LCD.h, SDP.c]
2011-09-28 Fix RFCOMM_SendFrame() to send the correct Poll/Final bit based on the frame type.
    [RFCOMM.c]
2011-09-29 Fix RFCOMM_FindChannel() skipping over non-closed rather than closed connections.
    Add UIH and DISC frame processing to the RFCOMM service.
    [RFCOMM.c, Speaker.h]
2011-09-29 Remove Client designator from the HID service, as all services will be dual role eventually.
    Add missing ACLChannel parameters from RFCOMM service processing routines.
    [BluetoothControl.c, BluetoothControl.h, HID.c, HID.h, RFCOMM.c]
2011-09-29 Add RFCOMM channel signal negotiation and fix broken RFCOMM multiplexer command processing.
    [RFCOMM.c, RFCOMM.h]
2011-09-29 Add RFCOMM channel callbacks and events.
    Fix RFCOMM PN control multiplexer command handler.
    [BluetoothControl.c, BluetoothControl.h, RFCOMM.c, RFCOMM.h]
2011-09-29 Add 100ms delay to the RFCOMM send function to prevent spontaneous system restarts - need to investigate further.
    Add sensor logging over the wireless RFCOMM serial port.
    Fix remaining references to the old Datalogger module names, replacing them with the new MassStorageDisk module name.
    [BluetoothControl.c, BluetoothControl.h, BluetoothRobot.c, BluetoothRobot.h, MassStorageDisk.c, RFCOMM.c, RFCOMM.h]
2011-09-29 Move sensor logging line creation to the Sensors platform, so that it can be re-used within the rest of the application with central routines for sensor data formatting.
    Add additional sanity checks to the RFCOMM service.
2011-09-29 Fix speaker sequence escape code being treated as a PWM frequency value.
    [Speaker.c, Speaker.h]
2011-09-30 Remove return value from the Sensor CSV line buffer routines, make caller responsible for determining line length.
    Update sensor CSV functions to use strcat() to reduce the compiled code size.
    Disable speaker output pin when not actively producing a tone.
2011-10-02 Fix Bluetooth_L2CAP_FindChannel() not using the local loop channel pointer for checks instead of accessing the L2CAP channel table directly.
    [BluetoothCommon.h, BluetoothL2CAP.c]
2011-10-02 Clean up sensor code to use local pointers to the sensor data structure.
    Add DISABLE_SPEAKER compile time option.
2011-10-02 Add ability to register SDP services to a specific stack, rather than all stacks in the device.
    Correct SDP and RFCOMM service initialization routines to allow for multiple stacks within the device.
    [RFCOMM.c, SDP.c, SDPServiceTable.h]
2011-10-02 Simplify note parser algorithm.
    Reduce sensor logging interval to 100ms.
2011-10-03 Keep track of the L2CAP channel allocations, increment after each new channel is created to prevent duplicate channel index allocations.
    [BluetoothCommon.h, BluetoothL2CAP.c]
2011-10-03 Add support for the RPN command in the RFCOMM service.
    Add missing ATTR_PACKED to Bluetooth service structures.
    [RFCOMM.c, RFCOMM.h, RFCOMMServiceTable.c, SDP.h]
2011-10-03 Don't send local channel signals until the remote device sets the ABM for the created channel.
2011-10-03 Fix incorrect RFCOMM Poll/Final flag set for UIH frames.
    [RFCOMM.c]
2011-10-03 Add .NET host application to graph the sensor data in real time from the robot.
2011-10-04 Use sign extension and latched interrupts on the BMA150 acceleration sensor.
    BMP085 pressure sensor data is 16-bit, as oversampling is not used.
    Remove zero calibration from the ITG3200 gyroscope sensor.
    Change sensor host visualizer application graph maximum/minimum values to suit the range of data the robot should encounter.
2011-10-05 Fix BMA150 sensor driver; switch back to automatic interrupt clear mode (instead of latched interrupt mode with explicit clear) and force the sensor out of sleep mode to enable reading of all three a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
    Alter sensors to all abort update if the corresponding sensor interrupt line is not active, as opposed to performing a blocking wait for the sensor to become ready.
    Add SIGN_EXTEND() macro for the sensors platform.
    [AK8975.c, AK8975.h, BMA150.c, BMP085.c, ITG3200.c, Sensors.c, Sensors.h, SensorsCommon.h]
2011-10-05 Update sensor host application with proper sensor scaling.
2011-10-05 Move temperature value scaling to the host PC application, rather than the robot.
2011-10-05 Fix host application Gyro formula and chart axis. Remove pressure Y axis label for now, as it is uncalibrated.
2011-10-05 Make L2CAP layer pass through the HCI layer for send/receive, for later HCI layer MTU management.
    Make L2CAP layer respect the remote device's channel MTU by fragmenting data into multiple HCI data packets.
2011-10-05 Fix broken L2CAP send code due to incorrect packet size calculations. Cache the HCI connection in the L2CAP send function, and pass the handle to the HCI packet send function to reduce latency.
    [BluetoothHCI.c, BluetoothHCI.h, BluetoothL2CAP.c]
2011-10-05 Add SDP table helper macros to simplify the creation of service attribute entries.
    Fix pressure sensor being cast to the wrong integer type size.
    [BMP085.c, BluetoothControl.c, RFCOMMServiceTable.c, SDP.c, SDP.h, SDPServiceTable.h]
2011-10-06 More cleanups to the RFCOMM SDP service attribute tables.
    Update Sensor Streaming host software to use graph scalings appropriate to the robot's movement via the onboard motors.
2011-10-06 Simplify Bluetooth HID packet parsing code.
    Add icon to host sensor logging application.
2011-10-09 Fix incorrect value of SENSOR_UPDATE_TICKS causing slow sensor updates.
    Add missing qualifiers to quench GCC 4.6 unused variable warnings.
    [BluetoothRobot.h, Endpoint_AVR8.h, Pipe_AVR8.h, RFCOMMServiceTable.c, Speaker.c]
2011-10-10 Fix FatDS disk_write() function not returning a correct error code if the write fails.
    Add additional Doxygen documentation.
    [Bluetooth.c, BluetoothAdapter.c, BluetoothCommon.h, BluetoothHCI.c, BluetoothHCI.h, BluetoothL2CAP.h, RFCOMMServiceTable.c]
2011-10-12 Make sure the RFCOMM service closes down all open channels and notifies the user application when the multiplexer is closed via a DISC command.
    Fix incorrect HCI_SendPacket() function definition.
    [BluetoothHCI.c, BluetoothL2CAP.c, RFCOMM.c]
2011-10-12 Make the sensor platform CSV string functions return the created length, since the calling code requires it anyway.
2011-10-12 Oops - BMA150 pressure reading is big-endian, not little-endian.
2011-10-13 Add user indicator when the HCI connection is rejected by the controller.
    Slow down RFCOMM sensor logging to prevent overloading the controller.
    Move HCI state change code to inside the Command Complete event processing code.
    [BluetoothHCI.c, BluetoothRobot.c, BluetoothRobot.h]
2011-10-13 Remove LCD_WriteBDADDR() and roll it's functionality into the places it is called to remove application-specific behaviour from the LCD driver.
    Reduce brightness of LCD when auto-dimmed.
2011-10-14 Allow for non on-the-spot rotation (UP-LEFT, UP-RIGHT, BACK-LEFT and BACK-RIGHT) rotations using a coordinate mapping system for the motor speeds.
    Fix motor driver mappings to the hardware for the motor channels.
    [BluetoothControl.c, Motors.c]
2011-10-14 Oops - disable correct PWM output GPIO pin when protecting against shorts due to slow switching transistors in the PWM controller.
    [Motors.c]
2011-10-14 Ensure the stack never sends more than the maximum allowable ACL data packets to the controller for each connection - excess packets are dropped and an error bubbled up to the sending service/applica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
    [BluetoothCommon.h, BluetoothHCI.c, BluetoothHCIEventCodes.h, BluetoothRobot.h]
2011-10-16 Add HCI Number of Packets Complete event definition, replace pointer math with the new packet struct.
    [BluetoothHCI.c, BluetoothHCIPacketTypes.h]
2011-10-16 Add additional HCI error codes to reduce use of magic constants.
    [BluetoothHCI.c, BluetoothHCI.h, BluetoothHCIEventCodes.h]
2011-10-16 Add missing structure packing attribute to local struct instances.
    [BluetoothHCI.c, BluetoothL2CAP.c, RFCOMM.c, RFCOMM.h, RFCOMMServiceTable.c, SDP.c, SDPServiceTable.h]
2011-10-17 Minor Doxygen documentation fixes.
    [BluetoothCommon.h, BluetoothHCI.c]
2011-10-17 Oops - fix broken HCI initialization sequence.
    Remove pointer-casting in the L2CAP layer, and replace with manual byte alteration code for clarity.
    [BluetoothHCI.c, BluetoothL2CAP.c]
2011-10-17 Pack the sensor structure so that casting it as a sensor structure array remains valid across multiple architectures.
2011-10-17 Reduce power consumption of the system; disable Analogue Comparator, make speaker driver turn the speaker output low rather than high impedance when the speaker is not in use.
2011-10-17 Make sure all possible USB init functions are run before testing for USB enumeration failure, to prevent multiple classes from being apparently active at the same time (due to C's logic short-circuit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
    [BluetoothRobot.c]
2011-10-17 Correct L2CAP data packets queued counter, but disable packet dropping for now as this causes issues with the Nintendo Wii controller.
    [BluetoothHCI.c, BluetoothL2CAP.c]
2011-10-18 Make host application process all queued data in the timer routine, rather than just the first queued item to prevent backlog of data if the timer is delayed.
2011-10-18 Bubble up L2CAP packet send errors through the RFCOMM packet send routines for later use.
    [RFCOMM.c]
2011-10-18 Perform endian swaps only at the point of packet encoding/decoding in the L2CAP layer, so that values are stored CPU-native within the internal structures for sanity.
    [BluetoothL2CAP.c]
2011-10-19 Encapsulate the Bluetooth Device Address as a distinct BDADDR_t type for clarity.
2011-10-19 In lieu of a reliable packet buffering layer, if the ACL Data buffers in the controller become full, wait for a fixed period for them to empty before continuing (temporary hack).
    [BluetoothL2CAP.c]
2011-10-20 Add the correct packet continuation flag for long HCI data packets.
    Make sure the entire L2CAP event structure is pre-zeroed, just in case an optional parameter is omitted.
    Add temporary fix for L2CAP packet loss - output pending packets to the LCD (delay period related?).
    [BluetoothCommon.h, BluetoothHCI.c, BluetoothHCI.h, BluetoothL2CAP.c, BluetoothL2CAP.h]
2011-10-20 Fix RFCOMM not setting the LSB to indicate a one byte data set when sending local port signals.
    Remove RFCOMM initialization sensor header and implement virtual DCD/RTS flow control, so that the robot will not attempt to send data until the host is ready for it.
    [BluetoothControl.c, BluetoothL2CAP.c, RFCOMM.c]
2011-10-22 Clean up L2CAP layer, make events use locally-respective channel number names rather than names relative to the command packet's contents.
    Ensure sensor data is only sent when the host device signals that it is ready for data via the RFCOMM virtual serial port signals.
    Simplify the host application's data splitting to remove the needlessly created dynamic array for the string splitting.
2011-10-22 Fix L2CAP channel connection responses not properly recording the created channel's remote channel number.
    Fix endianness conversions in the L2CAP layer - L2CAP channel object's contents are already in CPU native endianness.
    [BluetoothL2CAP.c]
2011-10-22 Simplify motor driver code.
    Move headlights state toggle into the application code, and out of the headlights driver.
2011-10-24 Move project code into a new Code/ subdirectory to separate the main project components.
    [ConfiguringApps.txt]
2011-10-24 Add SVN:eol-style property to source files so that they contain the correct end of line markings native to the target machine.
    [ConfiguringApps.txt]
2011-10-25 Add schematics to the Thesis document as an appendix.
2011-10-26 Thesis: Add document abstract and several abbreviations. Fix ordering of schematics in the appendix.
2011-11-09 Reduce maximum number of simultaneous connections/channels to a sane value for the test robot. Add extra sanity check to the HCI packet send function. Make motor driver default to idling the directio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
2011-11-10 Thesis: Replace photo showing speaker mounting with a better version, add motor controller design text.
2011-11-10 Thesis: Oops - add missing figure, correct references to the motor controller hardware figures.
2011-11-10 Thesis: Re-make schematic figures without f.lux turned on, so it doesn't look like I've been writing my thesis on the surface of Mars.
2011-11-10 Thesis: Add schematic and extra information for LCD hardware description. Start chapter 5 (robot firmware).
2011-11-11 Thesis: Add additional text for the Firmware Modules section. Remove Host Application User guide appendix (not needed). Update figures to use white borders around highlighted areas of photos to ensur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
2011-11-13 Add USB HID button mappings for the headlight toggle and novelty horn for generic HID devices.
2011-11-14 Thesis: Move source code dependencies text from the Robot Firmware chapter to the Source Code appendix. Fill out "Implications of this Technology" section with waffle about the future and wireless te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
2011-11-15 Thesis: Add photos of the completed PCB to the hardware chapter.
2011-11-15 Thesis: Add PCB line artwork.
2011-11-17 Thesis: Add SDP service implementation text and figures, spell-check Stack Implementation chapter. Remove off-white background from embedded schematics.
2011-11-17 Add additional top-down photo of the completed robot. Minor code style correction.
    [Bluetooth.h]
2011-11-18 Theis: Final proofing and editing before printing.
2011-11-18 Thesis: Commit final Thesis document output for printing.
2012-02-11 Extend the L2CAP event result value from 8-bit to 16-bit to avoid possible unwanted truncations.
    [BluetoothCommon.h]
2012-03-24 Fix minor bugs in the Bluetooth adapter binding routine; ensure that an events pipe is found, and that the Data IN and Data OUT endpoints are BULK type.
    [BluetoothAdapter.c]
2012-05-05 Fix typo in the Bluetooth Adapter control layer. Add missing initialization steps to the Mass Storage control layer to prevent failures with devices containing faulty USB flash disk firmware.
    [BluetoothAdapter.c, MassStorageDisk.c]
2013-05-08 Fix invalid corrupt response to SDP ServiceSearch requests (thanks to Chris)
    [SDP.c]
2013-06-27 Add missing MIT license from the Bluetooth stack portion of the code.
    [Bluetooth.c, Bluetooth.h, BluetoothClassCodes.h, BluetoothCommon.h, BluetoothHCI.c, BluetoothHCI.h, BluetoothHCIEventCodes.h, BluetoothHCIPacketTypes.h]
